jerabaul29/OpenMetBuoy-v2021a/development_environment/README.md

This contains information about how to set up your development environment to write / customize / develop firmware:

- **setup_arduino_v1-8_environment**: the arduino IDE v1.8 development environment, as used in the "legacy" instrument firmware.
- **setup_platformio_environment**: the PlatformIO development environment, as used in the "rewrite" instrument firmware.
