jerabaul29/OpenMetBuoy-v2021a/instrument_hardware/PCB.md

# Overview of the PCB(s) available

PCB makes assembly much easier and is the recommended way to assemble the OMB.

This is still a work in progress, if you want to get access to the current PCB, take contact directly through an issue or by email.
