jerabaul29/OpenMetBuoy-v2021a/latest_preprint_MDPI_2022.pdf

Citation: Rabault, J.; Nose, T., Hope, G.; Muller, M.; Breivik, Ø.; Voermans, J.; Hole, L.R.; Bohlinger, P.; Waseda, T.; Kodaira, T.; Katsuno, T.; Johnson, M.; Sutherland, G.; Johanson, M.; Christensen, K.H.; Garbo, A.; Jensen, A.; Gundersen, O.; Marchenko, A.; Babanin, A. OpenMetBuoy-v2021: an easy-to-build, affordable, customizable, open source instrument for oceanographic measurements of drift and waves in sea ice and the open ocean. Journal Not Specified 2022, 1, 0. https://doi.org/ (https://doi.org/10.3390/1010000)

Received:
Accepted:
Published:

Publisher’s Note: MDPI stays neutral with regard to jurisdictional claims in published maps and institutional affil-iations.

Copyright: © 2022 by the authors. Submitted to Journal Not Specified for possible open access publication under the terms and conditions of the Creative Commons Attri-bution (CC BY) license (https://creativecommons.org/licenses/by/4.0/).

Definitions/logo-mdpi-eps-converted-to.pdf (https://www.mdpi.com)

Article
OpenMetBuoy-v2021: an easy-to-build, affordable,

# customizable, open source instrument for oceanographic measurements of drift and waves in sea ice and the open ocean

Jean Rabault¹

, Takehiko Nose²

, Gaute Hope¹

, Malte Muller¹,3, Øyvind Breivik¹ , Joey
Voermans⁴

, Lars Robert Hole¹

, Patrik Bohlinger¹

, Takuji Waseda²,5, Tsubasa Kodaira² ,
Tomotaka Katsuno²

, Mark Johnson⁶

, Graig Sutherland⁷

, Malin Johanson⁸
, Kai Haakon
Christensen¹

, Adam Garbo⁹

, Atle Jensen³

, Olav Gundersen³

, Aleksey Marchenko¹⁰
,
Alexander Babanin⁴
1 | Norwegian Meteorological Institute
2 | The University of Tokyo
3 | University of Oslo
4 | The University of Melbourne
5 | Japan Agency for Marine-Earth Science and Technology
6 | The University of Alaska, Fairbanks
7 | Environment Climate Change Canada, Dorval
8 | UiT The Arctic University of Norway
9 | Carleton University, Ottawa, Ontario, Canada
10 | The University Center in Svalbard
* | Correspondence: jean.rblt@gmail.com

Abstract: There is a wide consensus within the polar science, meteorology, and oceanography communities that more in-situ observations of the ocean, atmosphere, and sea ice, are required to further improve operational forecasting model skills. Traditionally, the volume of such measurements has been limited by the high cost of commercially available instruments. An increasingly attractive solution to this cost issue is to use instruments produced in-house from open source hardware, firmware, and post processing building blocks. In the present work, we release the next iteration of the open source drifter and waves monitoring instrument of Rabault et. al. (see "An open source, versatile, affordable waves in ice instrument for scientific measurements in the Polar Regions", Cold Regions Science and Technology, 2020), which follows these solution aspects. The new design is both significantly less expensive (typically by a factor of 5 compared to our previous, already cost effective, instrument), much easier to build and assemble for people without specific microelectronics and programming competence, more easily extendable and customizable, and two orders of magnitude more power efficient (to the point where solar panels are no longer needed even for long term deployments). Improving performance and reducing noise levels and costs compared with our previous generation of instruments is possible in large part thanks to progress from the electronics component industry. As a result, we believe that this will allow scientists in geosciences to increase by an order of magnitude the amount of in-situ data they can collect under a constant instrumentation budget. In the following, we offer 1) detailed overview of our hardware and software solution, 2) in-situ validation and benchmarking of our instrument, 3) full open source release of both hardware and software blueprints. We hope that this work, and the associated open source release, may be a milestone that will allow our scientific fields to transition towards open source, community driven instrumentation. We believe that this could have a considerable impact on many fields, by making in-situ instrumentation at least an order of magnitude less expensive and more customizable than it has been for the last 50 years, marking the start of a new paradigm in oceanography and polar science, where instrumentation is an inexpensive commodity and in-situ data are easier and less expensive to collect.

Keywords: Waves in ice; Open Source; Instrumentation; In situ measurements; Oceanography; Waves; Sea surface drift; Open Ocean; Wave spectrum; Low cost.

Version February 14, 2022 submitted to Journal Not Specified | https://www.mdpi.com/journal/notspecified

Version February 14, 2022 submitted to Journal Not Specified | 2 of 26

### 1. Introduction

Our inability to accurately capture climatological changes of sea ice in the polar seas has created renewed interest in the dynamic interaction between sea ice and waves. This has resulted in the last few years into a number of studies that investigate the coupling between sea ice and the ocean through theoretical considerations [1–7], laboratory experiments [8–13], and field experiments [14–25]. Despite the advances that these studies bring, there is a growing consensus that further progress in the field can only be achieved through the collection of more observations of waves in ice. In particular, phenomena related to floe size distribution [4,26–28], energy dissipation due to turbulence and collisions [29–32], and sea ice breakup [33–36], are still unperfected modeled and understood, and advancing the state-of-the-art would require additional direct observations from the ice.
Unfortunately, one faces a number of challenges in reproducing the complexity of wave-ice interaction either in experiments (due to, for example, scaling issues [9], and the diversity and realism of sea ice conditions that can be obtained in the laboratory compared with the field [13]), or in models (there, also, due to the complexity and multi-scale proper- 43 ties of waves in ice and ice floe size distribution [37,38]). Arguably, the current state of the art in wave-ice interaction parametrization and modeling consists in a variety of (involved and mathematically advanced) models which formulations are relatively loosely based on some specific archetypical sea ice conditions and the associated physical mechanisms, with a number of "tuning parameters" that are empirically fitted to experimental or laboratory data [39,40]. This approach is quite ad-hoc and brittle, and this is in stark contrast with the importance of waves in ice and their impact on both weather and climate.
As a consequence, having access to large datasets of high temporal and spatial res- 51 olution direct observations of waves in ice, is a key ingredient to improving both small scale wave-ice interaction parametrization, large scale coupled wave-ice models, and our understanding of the weather and climate dynamics in the polar regions. There are a number of recent works that highlight the importance of the volume of such datasets for unveiling wave-ice interaction mechanisms. For example, Voermans et al. [15] showed that wave conditions that result in sea ice breakup events can be quite accurately described with a simple threshold mechanism, but that in order to be able to observe such a threshold, a relatively large aggregated dataset was necessary.
There are relatively few methods available for measuring waves in ice. The most common and established method considers the deployment of instrumentation in situ, providing surface truth of the sea ice motion under the influence of waves. Such instruments typically use either an Inertial Motion Unit (IMU, i.e. a combination of accelerometer, gyroscope, and magnetometer, together with some data fusion processing, e.g. Kohout et al. [41], Rabault et al. [42]), or a high accuracy GPS [43,44] to measure the sea ice motion and compute wave spectra. Less common techniques are the use pressure sensors to measure the wave-induced pressure fluctuation to derive wave observations [24]. Remote sensing is a promising avenue to obtain observations of waves in ice across large spatial scales [45,46] of far larger extent compared to what can be achieved with in situ instrumentation, though the number of wave parameters that can be retrieved, and the accuracy that can be achieved, is still limited and a topic for open research. Moreover, remote sensing requires considerable more in situ observations for calibration and validation. As a consequence, the most established and accurate method today is still to deploy instrumentation in situ to measure waves in ice.
Performing in situ measurements of waves in ice is, however, a challenging and costly operation. Commercial instruments have traditionally been extremely expensive, and sometimes of varying quality, with typical prices after taxes in the 7.5-50kUSD range. The situation got somehow better with the emergence of new actors, such as Sofar and their Spotter buoy [47], which took down the price to a typical 6-8kUSD cost per instrument, once

Version February 14, 2022 submitted to Journal Not Specified | 3 of 26

import taxes and satellite communication fees are factored in. Still, the Sofar Spotter, while gaining from being a very modern design, as well as relatively low cost, is not too well adapted for use in the polar regions, as it was designed primarily for measuring open water wave statistics, and, correspondingly, relatively large waves. In particular, its battery life limits the duration of deployments in the polar night [44]. In addition, its GPS-based wave measurement method, while having many advantages in open water (such as accurate directional wave spectrum measurement), has a lot higher noise for the typically small waves observed in the ice than what can be achieved with a modern Inertial Motion Unit (IMU).
As a consequence of these challenges, a number of groups have developed in-house, custom instrumentation for measurements of waves in ice [e.g., 41,42,48]. A very brief overview is provided in Fig. 1. This is, in our opinion, a situation that is so far quite inefficient. Indeed, a number of groups develop their own closed source solution, in parallel of each other, wasting a large amount of engineering resources in form of working hour and prototyping costs in the process.

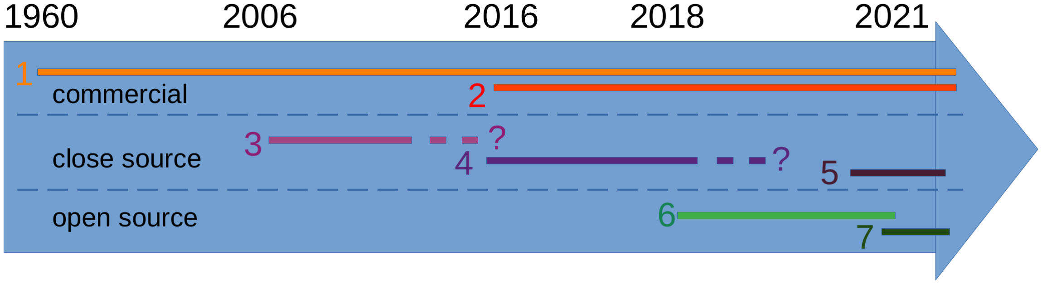
[picture p17: figure]

Figure 1. Overview of waves in ice instruments, distinguishing between i) commercial instruments, ii) close source instruments, iii) open source. Commercial instruments have been available for a long time, in particular the Datawell Waverider series of instruments (1), which goes back all the way to the 1960s [49]. More recently, the Sofar Spotter (2) has become a viable, lower-cost alternative, though there are a number of limitations in particular regarding battery autonomy [50], and the price. A number of groups have developed satellite-connected autonomous instruments that have been described in research articles, but that remained closed source. A few instruments we know about were released in 2006 (3) [48,51], 2016 (4) [41], 2021 (5) [25]. By contrast, our group has decided to release our designs as open source, so that can be freely used and improved by other groups, starting
in 2018 (6) [52] and now with the present design (7).
An increasingly promising direction is the development of open source instrumen- 95 tation, which allows to both reduce hardware costs and mutualize the instrumentation development workload. This approach was recently adopted by Rabault et al. [52] and has since its development in 2015 undergone several updates (the full lineage of our series
of open source instruments is presented in Fig. 2). In the following, we will refer to the design described in Rabault et al. [52] as the “v2018 instrument”, or “v2018” in short. Since 100 the initial deployment of the first v2018 instruments Rabault et al. [52], the low-cost and 101 open-source fundament of the instrument has promoted usage and international collabo- 102 ration across the world. The v2018, and adaptations thereof, have been deployed in both 103 the Arctic and Antarctic to study sea-ice drift [53], wave attenuation and dispersion [20], 104 and wave-induced sea ice break-up [15]. Through these collaborations and technological 105 advancements, points of improvement were identified, which supported to advance the 106 v2018 and develop the latest “v2021” version.
These challenges of high instrumentation costs and needs for more in-situ, ground 108 truth data, are not specific to the waves in ice community. Similarly, the rise of low cost (and 109 possibly open source) electronics is an evolution that is increasingly attracting the attention 110 of both research groups and public agencies across the world. For example, this trend can 111 be identified also in the technical development and history of the "Swift drifters" family, 112 among others, which are also advancing towards open source, low cost, "do it yourself" 113

Version February 14, 2022 submitted to Journal Not Specified | 4 of 26

technical solutions [54–56], focusing on measuring waves in the open ocean. Another 114 example of this trend is visible in recent works that focus on building small, inexpensive, 115 bio-degradable surface drifters [47]. Similarly, the Defense Advanced Research Projects 116 Agency (DARPA) is actively pursuing similar efforts with its "Ocean of Things" project 117 [57], which aims at "deploying thousands of low-cost, environmentally friendly, intelligent 118 floats that drift as a distributed sensor network" (quote from the Ocean of Things project 119
webpage, accessed Dec. 2021). | 120

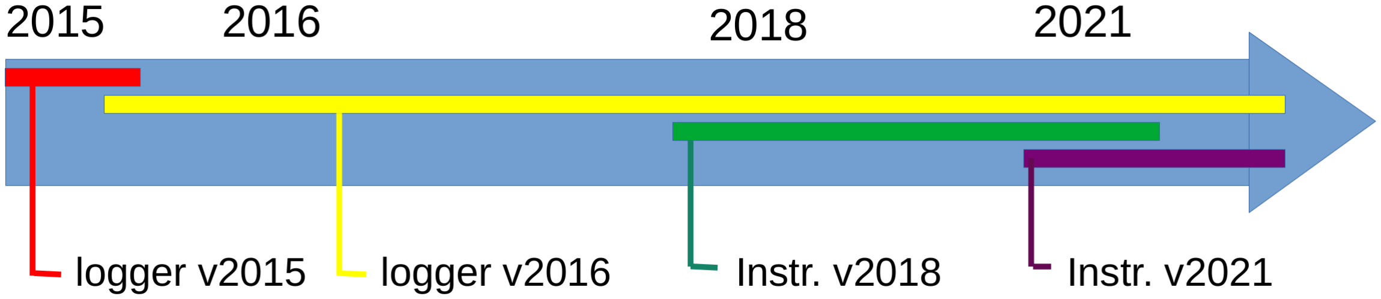
[picture p18: figure]

Figure 2. Full lineage of our present open source instrument. Developing reliable autonomous instruments is a long term effort. The development of our instrument can be tracked back to 2015
[42] and 2016 [22], though the instruments used at the time were simple loggers. Using loggers is still an attractive solution when the instruments can be recovered though, and the logger v2016 design is still in use today. By contrast our first truly autonomous, satellite-enabled instrument was designed
in 2017-2018 [52], and the present instrument is the second iteration around this design.

This paper is organized as follows. First, we discuss the general design and features 121 of the instrument v2021. Then, we present a detailed validation of the instrument v2021, 122 both i) in a preliminary deployment which aimed at validating the general concept of 123 the instrument and the power efficiency of the design, ii) in laboratory experiments that 124 tested the noise threshold of the waves measurements, iii) in a full-scale deployment in 125 the Russian Arctic, iv) in a full-scale deployment in the Caribbeans. Finally, we offer a few 126 words of conclusion and we present a roadmap for future development. All hardware 127 blueprints, embedded software, post processing codes, as well as detailed instructions, are 128
released as open source on Github, as indicated in the Appendix A. | 129
2. General design and features of the instrument v2021 | 130
2.1. Microcontroller | 131
Unlike the instrument v2018, and unlike all other wave measuring instruments that 132 we are aware of, the v2021 is based solely on a high performance microcontroller for 133 performing both data acquisition and in-situ data processing. This is a major shift from 134 previous designs, which usually resorted on some sort of embedded microcomputer for 135 performing the computation of wave spectra (typical previous solutions, such as those 136 based on a Raspberry Pi, run a stripped down version of Linux or Windows), with the 137 measurements themselves being performed either by the same microcomputer, or by a 138 separate, lower power microcontroller. This traditional approach has a dramatic effect on 139 power consumption. A typical microcomputer consumes around 1 to 2 W (for example, the 140 Raspberry Pi used in the v2018 consumes typically up to around 350mA while running 141 at a 5V voltage), while a modern microcontroller can consume as little as 1 to 2 mW 142 (the microcontroller used in the v2021 consumes typically 500 µA while running at a 143 3.3V voltage). This factor 1000 in power efficiency allows for significant simplifications 144 and flexibility in the instrument design. This is of particular importance to instrument 145 performance in the polar regions where the battery is generally the main limiting factor 146 in the field experiment duration. In addition, microcomputers will rely on a complete 147 operating system for running their workloads. These are complex pieces of software, with 148 several possibilities for things to go wrong, and require the user to implement a number of 149 techniques to avoid locking of the system. By contrast, microcontrollers can be programmed 150

Version February 14, 2022 submitted to Journal Not Specified | 5 of 26

without the use of any operating system, which allows to build more robust embedded 151
systems that are more reliable in demanding remote environments. | 152
To this end, the instrument v2021 uses an Ambiq Apollo 3 BLU ultra low power 153 microcontroller unit [58], embedded within a board from the Sparkfun Artemis ecosystem 154 [Artemis Global Tracker, 59]). This allows to use the complete Sparkfun Artemis ecosystem 155 toolchain to simplify the programming of the Ambiq Apollo using high level C++ code. 156 Effectively the user is able to use off-the-shelf, modular, high level libraries and does 157 not need to perform low level drivers and firmware development. The Ambiq Apollo 158 microcontroller used is an ARM Cortex M4-F implementation that runs at 48MHz (with 159 a 96MHz boost mode), uses 500 µA of sustained power at 3.3V, and features a complete 160 floating point unit for performing fast mathematical operations. Since this processor is 161 an ARM Cortex M4 implementation, the full ARM-developed libraries for digital signal 162 processing, including a wide range of spectral analysis tools, are available out of the box 163 through the Sparkfun toolchain which includes a copy of the CMSIS library (this features, 164 in particular, real and complex FFTs, cross correlation computations, and similar, which 165 are available as highly optimized, ready-to-use functions). The total non volatile memory 166 available for storing the program is amounting to 1MB, and the RAM has a size of 384kB. 167 To put this in perspective, storing 20 minutes of IMU data recorded at 10Hz into RAM, 168 processing the data, and sending the processed data through Iridium, occupies around 169 one third of the total memory available on the chip. This means that a lot of additional 170
customized functionality can be added in the future to the v2021. | 171
2.2. Wave data acquisition and on-board processing | 172
The wave data acquisition is performed by a 9 degrees of freedom (9-dof) sensor, which 173 performs high-frequency measurements of acceleration, angular rates, and magnetic field 174 on the X, Y, and Z axis of the sensor chip. An industrial quality, thermally compensated, low 175 noise sensor is used for this (the ST ISM330DHCX together with the LIS3MDL). At present, 176 only the vertical wave spectrum is computed, and the absolute orientation (provided by the 177 magnetometer) is not used but can be used in the future to derive directional information. 178 The raw accelerometer and gyroscope data are sampled at approximately 800Hz, and 179 time averaged into a 100Hz low-noise sensor value. When performing this averaging, a 180 3-sigma filtering stage is used, i.e., individual measurements that deviate from the rest of 181 the current 800Hz sample by more than 3 standard deviations are rejected. This means 182 that each set of 8 samples at 800Hz, spanning over 10 milliseconds, is filtered (with the 183 n-sigma filter) and averaged. This allows to discard occasional bad quality measurements 184 (in our experience, a few such measurements are obtained in a 20 minutes measurement 185 segment; this is most likely inherent to the kind of sensor used, and / or may come from 186 rare irregularity in the functioning of either the 9dof sensor or the firmware used for 187 communicating with it), to avoid any risk of signal aliasing, and to reduce the noise level 188 by performing averaging. This low-noise sensor value averaged at 100Hz is then fed 189 in real time to a Kalman filter run on the Ambiq Apollo microcontroller at 100Hz. The 190 Kalman filter itself is provided by an Attitude and Heading Reference System (AHRS) C++ 191 embedded open source library, provided to the community by Freescale Semiconductors. 192 The Kalman filter implementation performs data fusion for 9-axis MEMS input (i.e. 3-axis 193 accelerometer, gyroscope, and magnetometer), and produces an accurate estimate for the 194 absolute orientation of the sensor in a North, East, Down frame of reference. The Kalman 195 filter output is used for computing the vertical component of the wave acceleration at 196 100Hz by projecting the acceleration from the X, Y, Z frame of reference onto the vertical 197 direction, following the absolute orientation information provided by the Kalman filter as a 198 quaternion, and subtracting the constant gravity acceleration. Finally, the processed 100Hz 199 vertical acceleration measurement is time averaged to 10Hz. This output frequency is 200 sufficient to measure either wind waves (typical peak frequency 0.2Hz), swell (typical peak 201 frequency from 0.08 to 0.10Hz), and waves in ice (typical peak frequencies corresponding 202 to swell, or slightly lower, due to the increased damping rate at higher frequencies), 203

Version February 14, 2022 submitted to Journal Not Specified | 6 of 26

and is a value commonly used in other waves in ice instruments [52]. If necessary, this 204 output sampling frequency can be increased by the user, and the resources available on 205 the microcontroller could allow for at least 20Hz sampling rate. The whole procedure is 206 implemented through a couple of classes in the code and performed instantaneously. The 207 reader is referred to the open source implementation released on Github (see Appendix A) 208
for more details. | 209
Resorting to a simple 9-dof sensor and running the Kalman filter on the Artemis 210 microcontroller is both much more power effective (total power consumption is around 211 5mA for the proposed solution, compared with typically 35mA using a dedicated full- 212 feature IMU) and significantly less expensive than using a single discrete Inertial Motion 213 Unit component which performs both tasks on its own (the cost of a high quality 9dof sensor 214 is around 15USD, compared with 50 to 1000USD for a lower accuracy, or similar accuracy, 215 IMU, respectively). Pseudocode for the data acquisition and Kalman filter processing is 216
presented in the description of Algorithm 1. | 217

initialize empty BufferVerticalAcceleration10Hz;
initialize KalmanFilter100Hz;
while need more vertical acceleration measurements at 10Hz do
initialize empty BufferVerticalAcceleration100Hz
for CurrentVerticalAcceleration100Hz in [0..10[ do
initialize empty BufferAcc[X,Y,Z]800Hz, BufferGyr[X,Y,Z]800Hz, BufferMag[X,Y,Z]800Hz;
for Current9dofMeasurement800Hz in [0..8[ do
measure Acc[X,Y,Z] and append to BufferAcc[X,Y,Z]800Hz; measure Gyr[X,Y,Z] and append to BufferGyr[X,Y,Z]800Hz; measure Mag[X,Y,Z] and append to BufferMag[X,Y,Z]800Hz;
end
3-sigma-average BufferAcc[X,Y,Z]800Hz into Acc[X,Y,Z]Average100Hz; 3-sigma-average BufferGyr[X,Y,Z]800Hz into Gyr[X,Y,Z]Average100Hz; 3-sigma-average BufferMag[X,Y,Z]800Hz into Mag[X,Y,Z]Average100Hz; update KalmanFilter100Hz using Acc[X,Y,Z]Average100Hz, Gyr[X,Y,Z]Average100Hz, Mag[X,Y,Z]Average100Hz;
obtain QuaternionAbsoluteOrientation100Hz from KalmanFilter100Hz; compute CurrentVerticalAcceleration100Hz from QuaternionAbsoluteOrientation100Hz, Acc[X,Y,Z]Average100Hz; push CurrentVerticalAcceleration100Hz to BufferVerticalAcceleration100Hz
end
average BufferVerticalAcceleration100Hz into CurrentVerticalAcceleration10Hz;
push CurrentVerticalAcceleration10Hz to BufferVerticalAcceleration10Hz;
end
return BufferVerticalAcceleration10Hz;
Algorithm 1: Sampling of vertical acceleration at a frequency of 10Hz in a dedicated buffer, including raw data sampling and pre-averaging, Kalman filtering, and vertical acceleration post-averaging. "Acc" stands for "Acceleration", "Gyr" stands for "Gyroscope", "Mag" stands for "Magnetometer". 3-sigma-average is an averaging filter rejecting measurements deviating from the rest of the sample by more than 3 standard deviations, which is used to discard occasional bad readings. The combination of high-frequency averaging of the raw input from 800Hz to 100Hz, Kalman filtering and vertical acceleration computation at 100Hz, and vertical acceleration averaging from 100Hz to 10Hz, allows to balance the need for computational efficiency (by reducing the number of expensive Kalman filter updates) and accuracy (by running the raw data collection at high-frequency and using all the data available through time averaging).

The wave elevation data processing is also performed on the Ambiq Apollo micro- 218 controller. At the end of a 20 minutes measurement period (or, to be more exact, 20.48 219

Version February 14, 2022 submitted to Journal Not Specified | 7 of 26

minutes, to obtain a multiple of 2048 = 2

11 samples to allow much faster FFT computation), 220 the array of 10 Hz vertical acceleration data stored in RAM is processed using the Welch 221 method. For this, the signal is split into segments of length 2048 sample points, with a 222 75% overlap, resulting in a total of 21 segments. This corresponds to segments with length 223 double of what was used in Rabault et al. [52]. The motivation for doubling the segment 224 length is to increase the frequency resolution of the output. In addition, we use 75% overlap, 225 instead of 50% overlap used in Rabault et al. [52], in order to keep the number of segments 226 large enough to perform a good averaging despite the increase in segment length. The 227 real FFT for the vertical acceleration of each of these segments is computed using the real 228 FFT implementation provided by the ARM digital processing reference library, applying 229 Hanning windowing with an energy-conserving normalization, and these segment FFTs 230 are averaged into the Welch estimate. The computation of the FFT takes just a few tens of 231 milliseconds due to the dedicated floating point unit on the Ambiq Apollo microcontroller, 232 and the efficient FFT algorithm provided by ARM. The corresponding algorithm is sum- 233 marized in Algorithm 2. The reader who may want to re-implement a similar algorithm is 234 made aware that different FFT libraries may use different renormalization conventions, so 235 that using another FFT implementation may require the use of additional scaling factors. 236 In order to save memory, the Welch averaging is only performed for the set of frequency 237 bins corresponding to frequencies that are relevant for waves, which is typically between 238
fmin = 0.05Hz (i.e. 20s period waves) and fmax = 0.5Hz (ie 2s period waves). | 239
The Welch spectrum with Hanning windowing obtained at this stage is a low-noise 240 estimate for the spectrum of the wave vertical acceleration, PSDaccD. From there, the 241
spectrum of the wave elevation η can be obtained following [21]: | 242

PSDη(f) = PSDaccD(f)/(2.0π f)

4
. | (1)
Finally, the spectral moments are computed following: | 243

mi =

Z fmax

fmin

PSDη(f)f

i
d f , | (2)

and these are used to compute estimates of the significant wave height Hs and the wave 244
period Tz and Tc, following: | 245

Hs = 4

√
m0, | (3)

Tz =

p
m2/m0, | (4)

Tc =

p
m4/m2. | (5)

Since the full wave spectrum is transmitted (see the next section), these statistics are 246 simply redundant information (as they can be derived from the transmitted spectrum) 247 that are convenient to use for consistency checks, or for quickly inspecting wave data as 248 they are transmitted. We choose to transmit these quantities to remain consistent with the 249 previous design of Rabault et al. [52], as these are well adapted to our needs, but users 250 are free to implement the transmission of other statistics (such as the zero crossing period 251 T01 = m0/m1, or the harmonic period T−10 = m−1/m0) if this is a better fit for their needs, 252
owing to the open source nature of the instrument. | 253
We want to remind those readers who may want to re-implement this processing again 254 that different FFT packets may use different conventions, so that additional renormalization 255 factors may be needed. Similarly, some references in the literature use the angular frequency 256 ω = 2π f rather than the frequency f as a dimension for spectra, in which case some 257 additional renormalization is needed in the formula above. Our general recommendation 258 is to test the whole processing algorithm on dummy synthetic data to ensure that no 259 renormalization factor has been forgotten. Moreover, we used additional checks during 260

Version February 14, 2022 submitted to Journal Not Specified | 8 of 26

input: BufferVerticalAcceleration10Hz, length 6 * 2048 samples;
initialize array HanningWelchSpectrum[RelevantIndexRange] with all elements = 0;
// the RelevantIndexRange includes the reduced span of the 2048-point FFT
// that covers frequencies between 0.05Hz and 0.5Hz, ie from fmin to fmax initialize CurrentSignalSegmentStart = 0;
initialize CurrentSignalSegmentEnd = 2048;
for CurrentWelchSegment in [0..21[ do
copy BufferVerticalAcceleration10Hz[CurrentSignalSegmentStart..CurrentSignalSegmentEnd[ into CurrentFFTInput[0..2048[;
// apply Hanning windowing
for CurrentIndex in [0..2048[ do
CurrentFFTInput[CurrentIndex] *= 1.63 * [sin(π * CurrentIndex / 2048)]² end
compute realFFT of into HanningCurrentFFTOutput; HanningWelchSpectrum[RelevantIndexRange] += 2.0 * | HanningCurrentFFTOutput[RelevantIndexRange]²
| ;
// the realFFT of a real input signal is a vector of complex numbers; we need to extract the
// complex magnitude squared of each bin; in our case, a renormalization of 2.0 is needed since
// the output is only the half spectrum, i.e. the negative frequencies part of the spectrum
// which is equal to the conjugate of the corresponding positive frequency part is omitted
CurrentSignalSegmentStart += 2048 / 4;
CurrentSignalSegmentEnd += 2048 / 4;
end
HanningWelchSpectrum[..] = HanningWelchSpectrum[..] / 21;
return HanningWelchSpectrum;
Algorithm 2: Algorithm used for computing the Welch spectrum with energy-conserving Hanning windowing. We have decided to use 21 segments with 75% overlap when computing the Welch averaging. Note that the exact value of the renormalization coefficients needed may depend on the specific FFT implementation used and the normalization convention that it defaults to.

Version February 14, 2022 submitted to Journal Not Specified | 9 of 26

the development of the code to make sure that the scaling and processing as a whole is 261 correct, such as verifying that the Parseval theorem holds by checking that the variance of 262 the heave displacement is equal to the integral (with respect to frequency) of the power 263
spectral density. | 264
2.3. Satellite communications | 265
After the recorded data is processed, the data (composed of the Welch wave acceler- 266 ation spectrum between fmin and fmax, the estimates for Hs, Tz, and Tc, as well as UTC 267 timestamp information) are packed into a binary packet. In order to reduce the size of 268 the binary packet, the estimates for Hs, Tz, and Tc are transmitted as 32-bit floats, while 269 the Welch frequency bins are discretized into renormalized 16-bit unsigned integers. The 270 renormalization of the Welch bins is performed relatively to the peak value of the spectrum, 271 which is transmitted as a 32-bit float within the packet. This allows to significantly reduce 272 the size of the binary packets and the overall iridium costs while keeping a high accuracy 273
for the data transmitted. | 274
In addition to the wave spectrum, geographical positioning is obtained with a simple 275 GNSS module, and is also used to generate accurate UTC reference times and to periodically 276 re-calibrate the real time clock of the microcontroller to avoid time drift. The GNSS data 277 are packed, buffered, and transmitted using an efficient binary encoding, similar to what is 278
done for the wave data. | 279
The sample rate of both the GNSS and the wave measurements can be adapted through 280 2-way iridium communication. In addition, the real time clock present on board on the 281 microcontroller is used to make sure that the measurements are performed at fixed hours 282 and minutes. In order to reduce iridium costs and energy consumption, the firmware can 283 pack several binary packets packages together before transmitting these as a single iridium 284 message. As all iridium communications are buffered on the microcontroller, any data 285 not transmitted due to failure in iridium communication can be retransmitted at the next 286 transmission attempt to prevent data loss. When an Iridium communication is established, 287 the instrument transmits a burst of several messages, sending back to the user all the 288
information that are stored in the binary message buffers. | 289
A simple binary protocol decoder, available as a Python module, is provided alongside 290 the code for the instrument firmware. This, together with the web interface or web API 291 offered by modern Iridium providers (in our case, we use Rock Seven Mobile Services Ltd, 292 though other providers would be possible), allows great flexibility and ease-of-use for the 293 end user. Those tasks can easily be automated, and we provide a custom bash script for 294 performing https requests directly to the server of RockSeven, which allows to retrieve all 295
the iridium messages received over a user-selected time span, as a csv database. | 296
2.4. Ongoing instrument variant: cellular communication | 297
A derivate of the satellite based buoy is being developed to communicate through 298 the cellular network instead. Using the same data-processing and setup means that the 299 buoy takes advantage of the previous validation. The purpose of a buoy operating on the 300 cellular network is 1) lower cost (by a factor of 2 to 3 for the hardware, and up to 50 for 301 the communication), 2) higher data-rates: time-series of continuous measurements can be 302
transmitted if necessary. | 303
The buoy will operate under the limitation that it cannot stray far from the coast, and 304 the target areas reflect this: near-shore breaking wave measurements and drift and wave 305 measurements inside fjords in Norway. The buoy will be designed to store as much data 306 as possible locally if network service is temporarily unavailable. If the buoy runs out of 307 memory in the mean time it will drop uncritical data, and store only processed data. In 308 addition to the internal memory about 900kB of additional memory is available through 309 the cellular modem for caching data, and other memory devices may be added at small 310
extra cost and power usage if necessary. | 311

Version February 14, 2022 submitted to Journal Not Specified | 10 of 26
2.5. Battery autonomy and power-saving strategies | 312
Reliable power supply is a critical concern for waves in ice instruments due to the cold 313 temperature conditions and the inability for solar power usage during polar night. In the 314 present design, we decided to avoid the use of solar panels altogether (though solar panels 315 could be easily added for building an open ocean buoy with unlimited autonomy outside 316 of the polar regions). This allows to simplify the design, makes it less expensive and less 317 labor intensive to produce, as well as avoids compromising the water-tightening of the 318 instrument. In our case, the combination of a power-efficient microcontroller and 9dof, as 319 well as power-optimized firmware, led to a drastic reduction of the power consumption 320 compared with previous generations of the instrument. Table 1 summarizes the power 321 consumption of the instrument in different modes. We use as power sources Lithium 322 D-cells (SAFT LSH20), that have a nominal capacity of around 13Ah at 3.6V. In addition, a 323 3.3V step up-step down buck converter [60] is used to provide a stable 3.3V power source, 324 even when the iridium modem briefly needs to draw much more power (bursts up to 325 250mA). This results in a typical operational time, with 2 Lithium D-cells mounted in 326 parallel and no solar power, of around 4.5 months with our standard GNSS and waves 327 measurement rates (GNSS position every 30 minutes and wave spectrum every 2 hours). 328 If needed, increasing the number of batteries used in parallel will allow to increase the 329 autonomy, proportionally to the number of cells used. In order to simplify the handling and 330 deployment of the instrument, a magnetic switch was added to the design [61]. When the 331 magnet is attached, the instrument is powered down. The instrument starts operating as 332 soon as the magnet is removed, and can be switched on and off as many often as necessary. 333 Some LEDs are used to provide visual indication of instrument activity, while their blinking 334
frequency is taken low enough to preserve battery. | 335
activity mode | activation frequency | current (mA) | mWh use per hour | time to empty 2 Li D-cells
sleep | when not active | 0.3 | 1.0 | 7.3 years
gnss measurement | 2 minutes twice per hour | 30 | 3.3 | 2.2 years
wave measurement | 20 minutes every 2 hours | 8 | 4.4 | 1.6 years
iridium transmission | 1 message per hour | burst 250mA | 10 | 0.7 years
typical use | | | 18.7 | 0.39 years ≈ 4.6 months

Table 1. Overview of the power consumption and resulting battery autonomy resulting from the different components of the instrument when using two non rechargeable D-sized Lithium batteries. ’Activity mode’ indicates which part of the workflow of the instrument that is being considered. ’Activation frequency’ indicates a typical activation duration and frequency (though this is only indicative, and may be modified either by using different parameters when programming the instrument, and / or by sending updated activity rates through the bi-directional iridium communication). ’Current (mA)’ is the average current used in the corresponding mode when it is active. ’mWh use per hour’ indicates the corresponding energy use for the given activation mode, following the formula: mWhUsePerHour = Current(mA) × 3.3(V) × ActivationFraction.

The high level logics of the instrument (wake-up patterns, measurements patterns, 336 iridium burst mode transmission) is implemented as a few lines of code that leverage 337 an object oriented implementation of the processing components described above. To 338 increase robustness of the firmware after instrument malfunction, we resort to a double 339 strategy. First, the firmware is coded following defensive programming patterns, with 340 extensive quality checks of all inputs and outputs for the different modules used. Second, 341 the integrated hardware watchdog present on the microcontroller is enabled at all time, in 342 order to force a complete reboot of the microcontroller in case of a hardware or a software 343 malfunction. The test deployments have all been highly successful as described in Section 344
3, which is a testimony to the robustness of the design. | 345

Version February 14, 2022 submitted to Journal Not Specified | 11 of 26
2.6. Total cost and assembly process | 346
The total bill of materials is presented in Table 2. We consider that around 0.5 hours of 347 work is needed to assemble one single instrument. No advanced electronics or hardware 348 experience is required to build the instrument. At present, the assembly relies on a couple 349 of soldering steps to connect the power supply module to the main board, and simply 350 plugging the 9dof sensor and the electronic switch controlling it into the main board using 351
a couple of Qwiic I2C cables. | 352
component | function | price (USD) | assembly steps
Artemis Global Tracker | main board, MCU, GNSS, Iridium | 375 | ready to use
GNSS + Iridium antenna | passive antenna | 65 | screw on SMA cable
SMA extension cable 25 cm | extension cable for antenna | 5 | screw on tracker
Qwiic power switch | power on and off 9dof | 7 | disable LED, connect 9dof and tracker
ISM330DHCX + LIS3MDL | 9dof sensor | 18 | connect to power switch
Qwiic cables (x2) | connect tracker, 9dof, switch | 3 | connect power switch and 9dof
3.3V Regulator S7V8F3 | 3.3V buck converter | 10 | solder to battery and tracker
2 x D cell holders | house and connect batteries | 15 | solder to 3.3V regulator
2 x SAFT LSH20 | power supply | 35 | put in cell holders
reed MDRR-DT-20-35-F | magnetic switch | 3 | solder between battery and regulator
magnet | turn magnetic switch on / off | 1 | mount outside housing
housing box | housing, IP68 | 20 | mount the electronics inside
misc: glue, wire | small extras | 5 | get the design assembled
total | fully functional instrument | 562 | 0.5 hours / instruments, producing 10
Table 2. A representative list of components needed to build an instrument monitoring drift (GNSS) and wave activity (9dof sensor). The assembly time for a single instrument, when assembling a series of 10 instruments in bulk, is about 0.5 hours once the user is familiar with the design.
functionality | credits / message | messages / hour (default) | price / month (USD)
iridium subscription fee 1 month | N/A | N/A | 16
GNSS position data | 2 | 0.3 | 26
wave spectrum data | 3 | 0.5 | 66
total | N/A | N/A | 108
Table 3. Overview of the Iridium communication costs. The prices correspond to the ones offered by RockSeven at the time of writing this manuscript. It is possible to modify the rate of data collection by either using different setups when one programs the instrument firmware, or by sending a measurement rate update command to the instrument through iridium.

The total weight of the instrument depends on the size of the enclosure and the number 353 of battery cells used. Typical weight is between 0.3 and 0.5kg with 2 lithium D-cell batteries. 354 The dimensions of the instrument are typically around 12cm x 12cm x 9cm. Many of these 355 parameters are part of design tradeoffs. For example, more batteries increase weight and 356 would make deployment from drones more challenging, but also allow to extend battery 357 time. The use of a small enclosure allows for easier shipping and logistics and make the 358 instrument less likely to be discovered (and destroyed) by polar bears (in the Arctic), but 359 means that even a relatively minor snowfall is enough to bury the instrument and interrupt 360
GNSS and Iridium signals. | 361
In addition to the construction costs, Iridium costs can be significant over time. Table 362 3 indicates the typical Iridium communication costs per month, for an instrument running 363 with the default parameters (reducing the frequency of measurements will reduce costs 364
accordingly). | 365

Version February 14, 2022 submitted to Journal Not Specified | 12 of 26

Combining the building and the Iridium costs, the total cost per instrument, for an 366 activity period of 6 months (which is reasonable for instruments deployed in the MIZ at the 367 start of the ice formation season), is around 1200 USD, all included (noting that 4, rather 368 than 2, LSH20 batteries will be necessary for such a deployment). Around 53% of this cost 369 comes from the Iridium transmission fees, so reducing the frequency of measurements 370 when little activity of interest is happening will allow to significantly reduce the total cost 371
of ownership. | 372
3. Validation of the instrument v2021 | 373
3.1. Autonomy and satellite communication test in the Arctic: February 2021 deployment | 374
An early version of the instrument v2021, which performed drift tracking but no waves 375 measurements, was deployed East of Svalbard in February 2021 [62]. This early version 376 of the instrument was used to i) validate the general design of the electronics, ii) validate 377 the low power modes and the ability of the instrument to live for several months in the 378 Arctic cold using just a couple of D-sized battery cells, in particular, regarding the power 379 consumption of the iridium modem which is hard to estimate, iii) validate the satellite 380
communication binary protocols. | 381
This initial test was a success. The instrument was deployed on February 24th, 2021, 382 East of Svalbard. It then transmitted data for a few weeks, before a snow storm covered 383 it with snow and blocked the iridium transmission. This loss of communications is a 384 consequence of the design of the housing of the instrument, that relied on a box that was 385 too low to survive even just 10 cm of snow, and will be addressed in future designs, by 386 using a box that is higher and does not get buried as easily. However, communication with 387 the Iridium satellites was restored when the ice melted in late May 2021. Following this, 388 the instrument freely floated in the open sea, traveling all the way from Svalbard to the 389 close vicinity of Murmansk, and back and forth between Novaya Zemlya and Murmansk. 390 An overview of the trajectory is presented in Fig. 3. At the time of writing this 391 manuscript, i.e. January 2022, this instrument is still transmitting. The instrument was 392 powered by 3 LSH20 batteries, which, since it measures only GNSS position each 30 393 minutes, should result in a battery life of around a bit over 1 year following the data from 394 Table 1. Therefore, this deployment validates the low power design, and confirms that both 395 the low power sleep mode, the GNSS data acquisition, and the Iridium transmission (which 396 have the power consumption that is most difficult to estimate), are correctly implemented 397
and allow extended operation on battery alone. | 398
3.2. Experiments for validation of small-amplitude, low frequency harmonic vertical displacement | 399
measurements at the University of Tokyo’s wave-ice tank facility: July 2021 laboratory test | 400
We conducted an experiment in July 2021 to evaluate the instrument v2021 accuracy 401 for measuring small amplitude harmonic vertical displacement representative of waves 402 in ice. This experiment allows to fully validate i) the acquisition of raw data from the 403 9dof sensor, ii) the processing algorithm and scaling factors used in the low-level signal 404 processing code, iii) the data encoding used for transmitting the information back to the 405 user. The experiment took place in the wave-ice tank facility at the Kashiwa campus of 406 the University of Tokyo, Japan. In our case, however, the instrument v2021 prototype 407 was placed on the top of the wavemaker paddle (which is a plundging wedge, vertical 408 displacement paddle), rather than in the water (see Fig. 4), so it measured the vertical 409 motion of the wavemaker itself, which is known to a very high accuracy thanks to the 410 use of a close-loop control. Indeed, even given the presence of a damping beach, it would 411 be challenging in such a small wavetank to avoid reflections and standing waves, and to 412 provide waves of sufficient amplitude at such low frequencies. By contrast, by placing the 413 instrument on top of the paddle which is controlled by a close loop constrol system, we 414 ensure that the vertical displacement of the instrument is exactly equal to the one specified 415 in the control system. In this section, we will refer to the displacement prescribed as 416 "wavemaker signal", to emphasize that the signal we measure is the vertical displacement 417

Version February 14, 2022 submitted to Journal Not Specified | 13 of 26

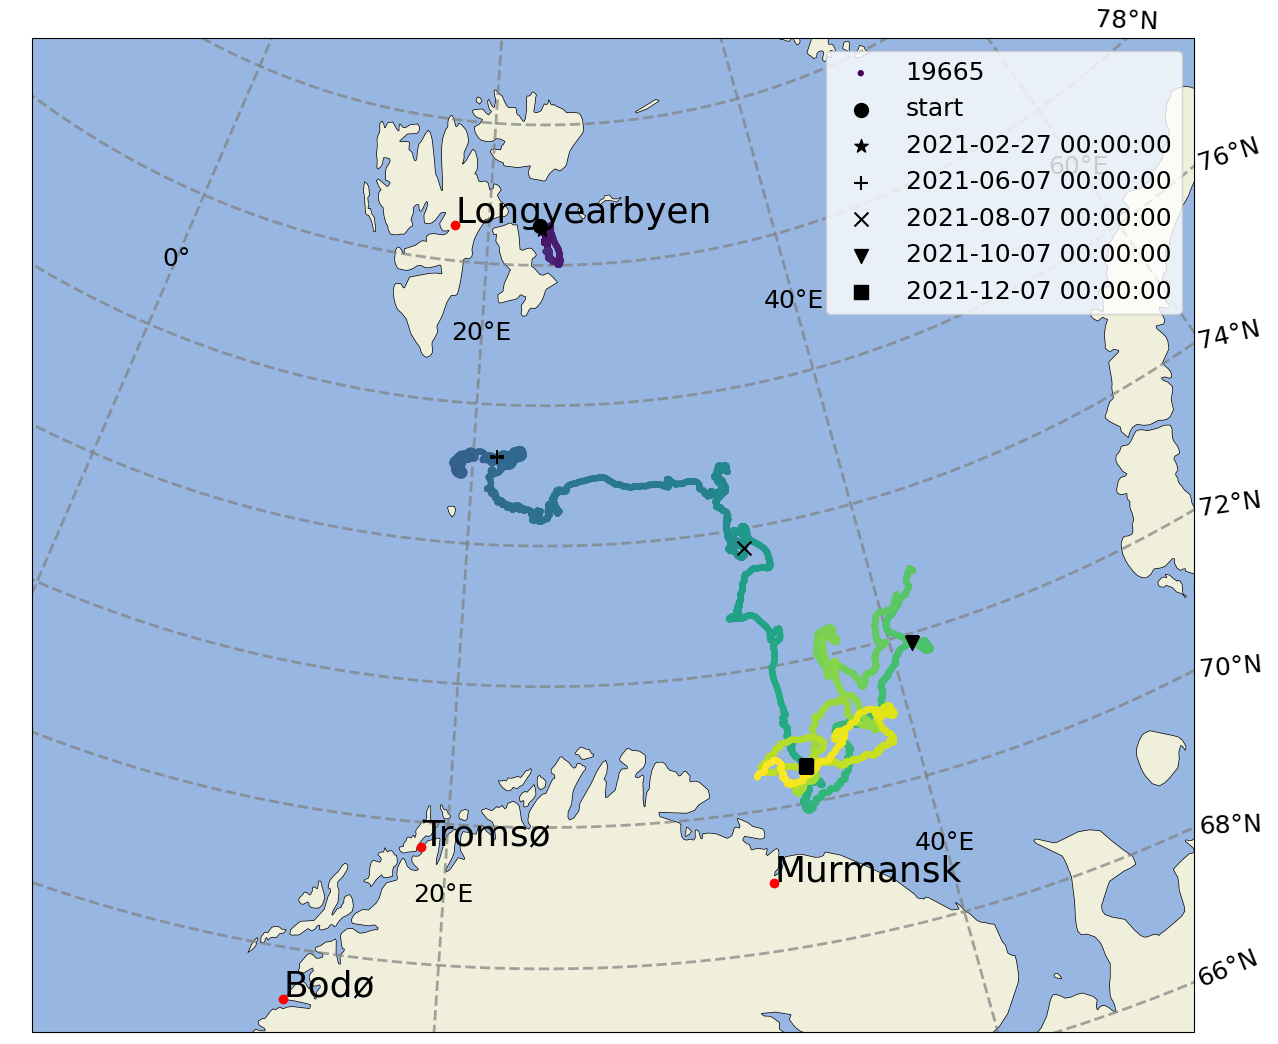
[picture p19: figure]

Figure 3. Overview of the drift trajectory of the early prototype instrument deployed in February 2021 East of Svalbard. The interruption in the trajectory is due to a layer of snow covering the instrument that prevented satellite communications during a couple of months. The instrument then drifted freely in the open ocean. This validates the low power design, and confirms that the design chosen is able to sustain operations for several months using just a few D-cell Lithium batteries.

of the plunger-type wavemaker on which the instrument sits, rather than the motion of the 418
water. | 419
The experiment aims to evaluate the instrument accuracy when it measures centimeter 420 scale vertical displacement signals at low frequencies corresponding to typical waves in ice 421 conditions. As such, we tested the instrument using both 1 and 2 cm amplitude sinusoidal 422 wavemaker vertical motion for 12, 14, and 16 s periods (as well as an "extreme" test with 0.5 423 cm amplitude and 16 s period, to test the very limit of the instrument sensitivity), which 424 resemble lower-bound wave signals that were previously measured in ice-covered ocean 425 [15]. The spectral analysis setup was slightly modified from that of Section 2.2, so that 426 each test case duration was reduced from 20 mins to roughly 7 mins, in order to be able to 427 perform the tests within the allocated time slot. For this, the segment overlap was reduced 428 to 50% (corresponding to 1024 points), which yields a total number of 3 segments per 429 7 mins measurement interval. All other processing configuration remained the same as 430
Section 2.2. | 431
The wavemaker signal experiment results are summarized in Table 4. The frequency 432 of the wavemaker motion was not tuned to the exact frequencies bins, nevertheless, the 433 peak of the energy was consistently captured in the nearest frequency bin, as reflected in 434
Table 4. Then, the best estimate of the wave amplitude can be derived as: | 435

Amono =

q
d f × (S(i − 1)

2 + S(i)

2 + S(i + 1)

2), | (6)

where S(i) is the spectrum produced by the instrument, taken at the peak of the amplitude 436 spectrum, and we consider also the neighboring frequency bins. The results of the wave- 437 maker signal experiments summarized in Table 4 indicate that the instrument is capable of 438 measuring monochromatic wave amplitudes of 1 to 2 cm with roughly 0.1 cm accuracy. 439 The spectra obtained during these tests, as well as two spectra corresponding to the 440 instruments being at rest, are presented in Fig. 5. As visible there, the noise background 441 of the instrument increases slightly when motion is present, which may be explained by a 442 variety of reasons (small vibrations in the wave paddle mechanism when it is undergoing 443 displacement, diffusion of numerical noise in the processing algorithms, inherent properties 444

Version February 14, 2022 submitted to Journal Not Specified | 14 of 26

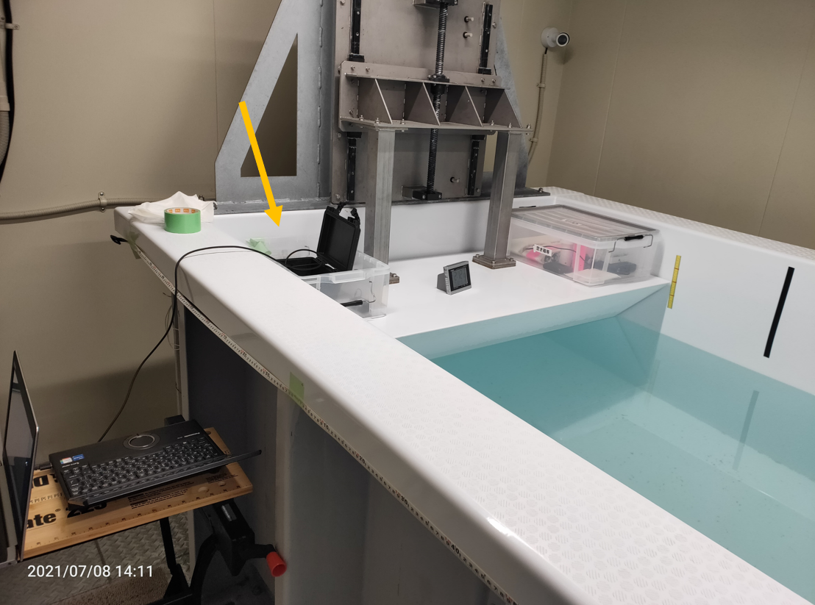
[picture p20: figure]

Figure 4. Illustration of the wavemaker experiment setup in the wave-ice tank of JAMSTEC (Japan Agency for Marine-Earth Science and Technology) at the Kashiwa campus of the University of Tokyo, Japan. The instrument v2021 location is shown by the yellow arrow.

Wavemaker signal: amplitude, period | Reported buoy amplitude (cm, averaged) | Reported buoy peak period (s) | frequency bin closest to peak frequency | Number of cases
2 cm, 16 s | 2.104 | 15.75 | yes | 4
1 cm, 16 s | 1.040 | 15.75 | yes | 2
0.5 cm, 16 s | 0.62 | 15.75 | yes | 2
2 cm, 14 s | 1.954 | 13.65 | yes | 1
1 cm, 14 s | 1.053 | 13.65 | yes | 1
2 cm, 12 s | 2.022 | 12.05 | yes | 2
1 cm, 12 s | 0.970 | 12.05 | yes | 2

Table 4. A summary of wavemaker signal experiment results. The experiments included 1 and 2 cm amplitude waves for 12, 14, and 16 s periods, as well as an "extreme" test corresponding to an amplitude of 0.5cm at 16s period. When multiple tests were conducted, the mean values are reported. The instrument is able to accurately measure waves down to 1 cm at a 16s period, with a corresponding typically accuracy of under 0.1 cm. For waves of amplitude 0.5cm and period 16s, the peak period is still correctly identified, but noise in the measurements starts to play a role, with a deviation of around 25% in the wave amplitude value reported.

Version February 14, 2022 submitted to Journal Not Specified | 15 of 26

of the 9dof sensor). However, the increase in the noise threshold when there is motion 445 remains very limited. The signal-to-noise ratio is superior or equal to a factor of 50 in 446 all experiments, except for the smaller waves (0.5cm at 16s period), in which case the 447 signal-to-noise ratio is around 10. This means that, even in this last "extreme" test case, 448 the signal-to-noise ratio is still good enough to clearly distinguish the motion from the 449 noise floor, though noise starts to be visible in the integrated statistics, as discussed in the 450
previous paragraph and in Table 4. | 451

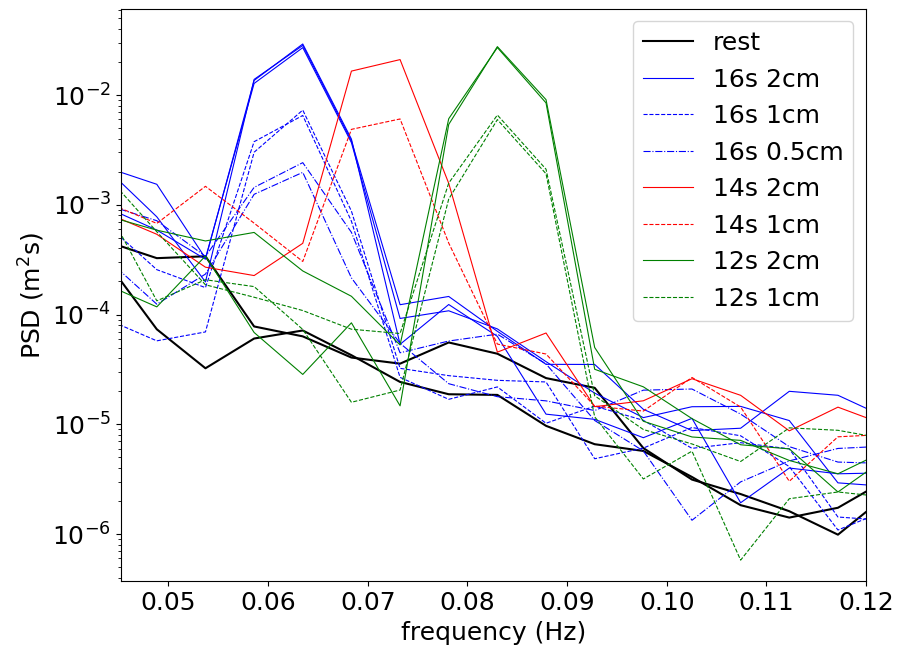
[picture p21: figure]

Figure 5. Spectra obtained when testing the instrument v2021 in the laboratory. The signal-to-noise ratio is superior or equal to 50 for all test cases, except the "extreme" test case with displacements of amplitude 0.5cm and period 16s, where the signal-to-noise ratio is around 10. The noise threshold obtained when the instrument is at rest is actually slightly better than what was obtained with the instrument v2018 (compare the present plot to Fig. 3 of Rabault et al. [52], curves "IMU 1" and "IMU 2").

Following this successful laboratory validation, we decided to perform a field valida- 452
tion experiment in the Arctic, which is described in the next subsection. | 453
3.3. 2021 NABOS expedition and comparison with SOFAR Spotter buoy in the Marginal Ice Zone 454
in the Arctic: September 2021 deployment | 455
The first field deployment opportunity for the full-feature instrument v2021 was the 456 2021 Nansen and Amundsen Basins Observational System (NABOS) expedition (https: (https://uaf-iarc.org/nabos-cruises/) 457 //uaf-iarc.org/nabos-cruises/), which was performed in the context of the ArCS II Japan- 458 Russia-Canada International Exchange Program (https://sites.google.com/edu.k.u-tokyo. 459
ac.jp/arcsii-iep-jrc/main). (https://sites.google.com/edu.k.u-tokyo.ac.jp/arcsii-iep-jrc/main) | 460
A v2021 instrument was assembled in a Zeni Lite drifting buoy, referred to Zeni- 461 v2021 in the following (see Appendix B for the buoy assembly details). This instrument 462 was deployed alongside a commercial wave measuring device (SOFAR Spotter drifting 463 buoy, https://www.sofarocean.com/products/spotter), referred to as SPOT-1386 in the 464 following. The key difference of the Spotter compared with the instrument v2021 is that 465
the Spotter measures surface displacements based on GNSS signal. | 466
On 15 September 2021, both buoys were deployed adjacent to the ice edge in the 467 central Arctic Ocean (North of the Laptev Sea), at a location of 81.915◦ N 118.763◦ E, at 468 around 05:05 UTC. The buoy deployment location is shown in Fig 6, which is overlaid 469 with 0.15 and 0.80 sea ice concentration (SIC) contours based on the Advanced Microwave 470
Scanning Radiometer 2 (AMSR2) data [63]. | 471
The two buoys drifted apart roughly 1 km within 8 hours of being deployed and 472 farther than 3 km after 24 hours. Given that the ocean surface conditions near the ice 473 edge are heterogeneous, we compared the instrument v2021 spectrum with that of SPOT- 474 1386 following the deployment, when they are still close to each other. The buoy spectra 475 compared generally well when the buoy distance was less than 1 km. The left panel in Fig 7 476 shows the buoy spectra at 08:21 15 Sep 2021, which corresponds to a moderate significant 477 wave height Hm0=1.62 m. The comparison indicates that the spectra compare well when the 478 low frequency noise, which is typical in accelerometers, is discarded. Here, the method that 479

Version February 14, 2022 submitted to Journal Not Specified | 16 of 26

was previously used in [64,65] was applied to remove this noise from Zeni-v2021 spectra. 480 An ideal filter was applied to remove data below the lowest frequency local minimum of 481 the smoothed spectrum. In addition, another spectra comparison on 08:21 16 Sep is also 482 provided on the right panel in Fig 7. By this time, the buoys were farther than 3 km apart, 483 so there is a slight difference in energy levels between the two buoys, but the general shape 484 of the spectra is comparable. These buoy spectra comparisons indicate that the instrument 485 v2021 can be used to measure ocean waves, and is a full scale, fieldwork validation of the 486
algorithms and processing used. | 487
Spotter buoys, without solar radiation recharge at high latitude during the winter 488 season, have only a short life span and SPOT-1386 ran out of battery on September 30th 489 2021. Analysis into the co-located deployment in and near the Marginal Ice Zone MIZ is 490 ongoing and will be presented in a separate, science-focused paper. Notwithstanding, a 491 comparison of wave periods (peak period Tp and spectral period T0m1) when the buoys 492 were less than 5 km apart agree within better than 5%. In addition, the part of the dataset for 493 which both instruments are frozen in the ice indicates that the noise level of the IMU-based 494 instrument (typically around 0.1cm) is much better than that of the Spotter buoy (typically 495 around 1cm), which is expected due to the different data sampling techniques used (GPS vs. 496 9dof). This provides further support that Zeni-v2021 captured consistent energy densities 497 to those of SPOT-1386, and that the Zeni-v2021 is actually better suited for measuring 498 small waves in ice. Note that the analysis into the Zeni-v2021 and SPOT-1386 co-located 499 deployment is described in a manuscript under preparation, which is why these data are 500
not released in the present technical paper. | 501
Regarding battery life, the estimated deployment duration for hourly wave sampling 502 rate was 3.3 months based on Table 1 where 2 Tadiran D-cell batteries (TL-5930/S), each 503 with 19 Ah capacity, were used as the power source. The instrument stopped transmitting, 504 likely due to empty battery, in mid-December, i.e. 3 months after the start of the deployment. 505 This corresponds well to the estimated battery life, and this is an additional confirmation 506 of the quality of the design of the hardware and software, in particular regarding the 507
implementation of low power modes. | 508

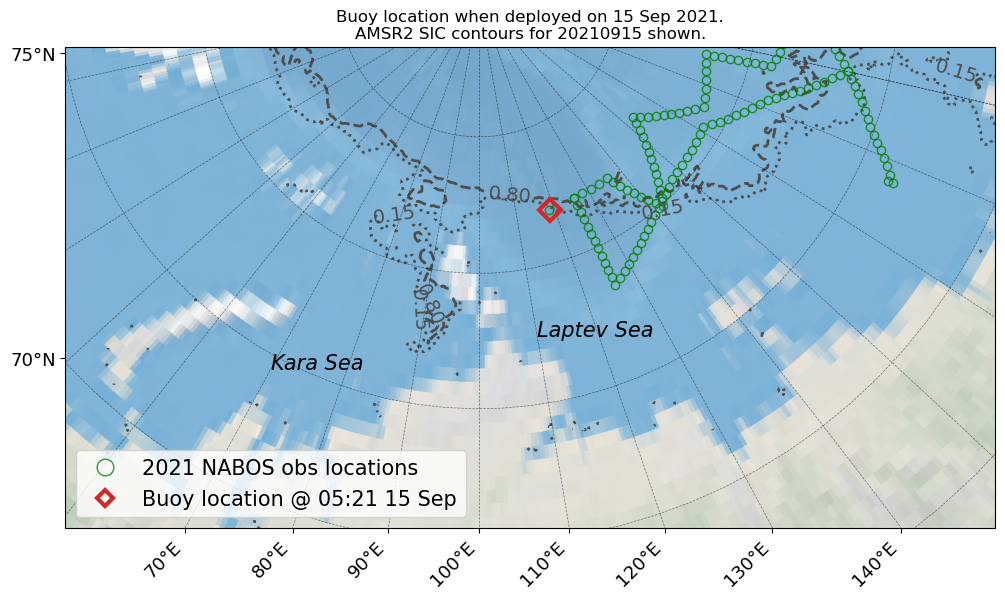
[picture p22: figure]

Figure 6. Zeni-v2021 and SPOT-1386 deployment location on 15 Sep 2021. The 2021 NABOS observation locations also shown in green markers, and AMSR2-derived 0.15 and 0.80 Sea Ice Concentration (SIC) contours for the same day are overlaid.

3.4. The "Floatenstein" drifting buoy in the Caribbeans: November 2021 | 509
A small-scale, home-produced drifting buoy was built following the v2021 design in 510 the context of the OneOcean expedition, a circumnavigation by the Norwegian tall ship 511

Version February 14, 2022 submitted to Journal Not Specified | 17 of 26

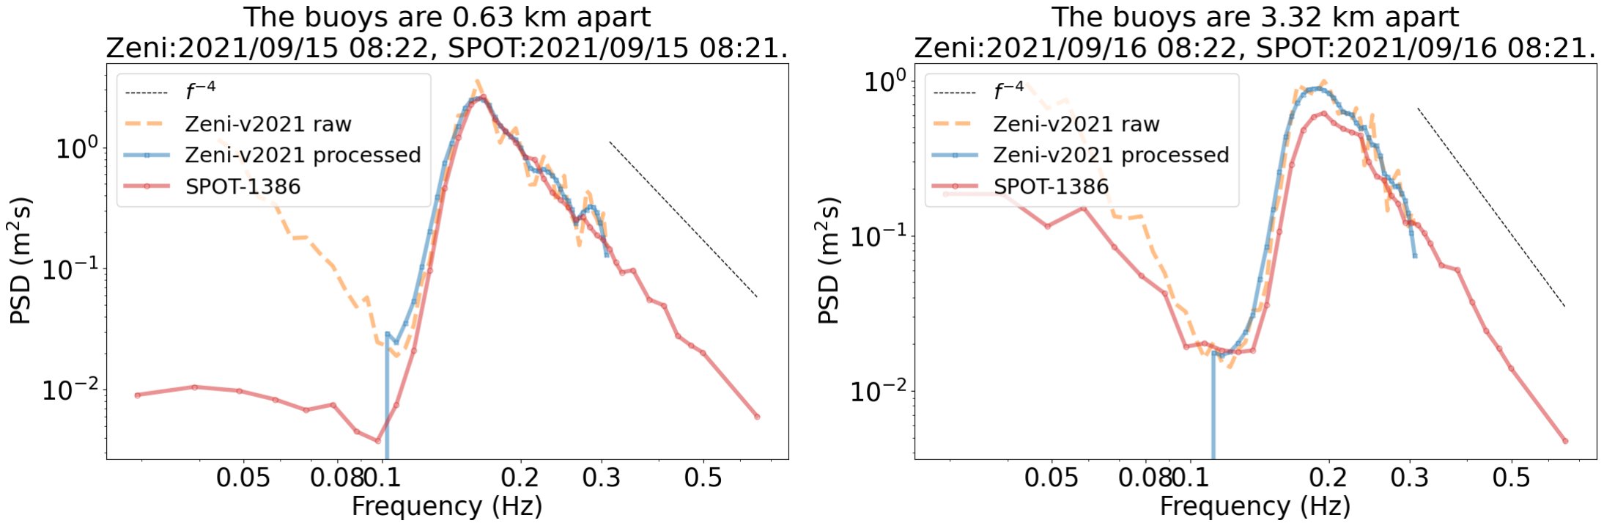
[picture p23: figure]

Figure 7. Comparison of Zeni-v2021 and SPOT-1386 spectra at 08:21 15 Sep 2021 (left) and 08:21 16 Sep 2021 (right): the distance between the buoys were roughly 1 km and 3 km, respectively. Low frequency noise of Zeni-v2021 spectra was removed by applying an ideal filter at the lowest frequency local minimum of the smoothed spectrum, similarly to what was reported in Waseda et al. [64], Nose et al. [65], which is a common post processing step when working when accelerometer-derived wave data. This indicates agreement within typically 5% between the Sofar Spotter and the instrument v2021 measurements in the open water, before the instruments drift away from each other.

Statsraad Lehmkuh. The electronics are identical to everything that was discussed above, 512 except for the battery solution used. Indeed, since the instrument had to be transported by 513 plane in the checked luggage of an expedition member, 2 traditional alkaline D-cell batteries 514 were used instead of the Li-batteries of the other instruments. A standard rectangular rigid 515 plastic enclosure of size 12cm x 12cm x 9cm was used as the main body of the buoy. Since 516 alkaline batteries are heavier than lithium batteries, this resulted in too low floatability. 517 As a consequence, we added small chunks of styrofoam (wrapped in duct tape to protect 518 from abrasion from the elements), on the sides of the rigid plastic enclosure, in order to 519 increase buoyancy. These additional buoyancy elements were set in place using cable ties 520 and glued in position using bathroom silicone sealant. In addition, the rigid plastic box 521 was fully sealed with epoxy glue, to make it fully watertight. Finally, a keel composed 522 of diverse scrap metallic parts (spare screws and bolts), packed in duct tape, was fixed 523 at the bottom of the plastic enclosure to improve its static stability. This combination of 524 disparate building materials gave a very peculiar appearance to the drifting buoy, which 525 got nicknamed humouristically as "Floatenstein" (Floating-Frankenstein). A picture of the 526
instrument, fully built before being shipped, is presented in Fig. 8. | 527
Despite its unusual appearance, Floatenstein proved to be a robust and well-functioning 528 drifter. Floatenstein was released in the open ocean on November 11th 2021, and, at the 529 time of writing this manuscript (January 2022), Floatenstein has been active for a bit over 530 two months and is working nominally. Data transmitted include i) GPS position sampled 531 each 30 minutes, and ii) vertical wave spectrum sampled each 2 hours, similar to what is 532
described in Section 2. | 533
In order to validate the good functioning of Floatenstein and the electronics inside, 534 we compare the wave data transmitted by Floatenstein with direct satellite altimeter 535 measurements. The Wavy software package (see https://github.com/bohlinger/wavy, 536 Bohlinger et al. [66]) is used to perform i) gathering of relevant satellite data, ii) collocation 537 with the position of Floatenstein, iii) extraction of relevant fields. For the collocation 538 process, the temporal and spatial constraints are 30 minutes and 50 km, respectively. Four 539 satellite missions had coinciding satellite measurements Sentinel-3A/B, Jason-3, and the 540 altimeter mounted on CFOSAT. The satellite observations are of level 3 processing quality 541 and publicly available in the Copernicus CMEMS archive¹
. | 542
Results of the comparison between Floatenstein and satellite data are presented in 543 Fig. 9. The satellite data are naturally spaced in time, due to the orbital pattern of the 544

1 https://resources.marine.copernicus.eu/product-detail/WAVE_GLO_WAV_L3_SWH_NRT_OBSERVATIONS_014_001/INFORMATION (https://resources.marine.copernicus.eu/product-detail/WAVE_GLO_WAV_L3_SWH_NRT_OBSERVATIONS_014_001/INFORMATION)

Version February 14, 2022 submitted to Journal Not Specified | 18 of 26


Figure 8. The "Floatenstein" drifting buoy. The main body of the buoy is a rectangular plastic box of dimensions 12cm x 12cm x 9cm. Due to the use of alkaline batteries instead of lithium batteries, additional floatation elements were needed. These are the two rectangular elements on the side of the main body of the buoy, which are built from styrofoam chunks, wrapped in duct tape, and held in place by cable ties. The full box is sealed with epoxy to be perfectly water tight. To avoid the need for making holes in the box, the Iridium antenna is also taped in place inside the box, immediately under the lid, pointing 45 degrees upwards. The small cubic magnet (wrapped in duct tape to hold it in position under transport), which controls the magnetic switch glued on the inside of the box, is visible on the front panel of the main body of the drifter.

satellites collecting the data. The wave statistics reported by Floatenstein lies within the 545 typical error margin of the direct observation by the satellites, which is visible as the spread 546 in significant wave height over each small transect cutting the trajectory of Floatenstein. 547 This is an additional confirmation of the good functioning of the electronics and firmware 548 of the instrument v2021, as well as an illustration that even coarse drifters are able to 549 accurately measure wave properties, as long as these are small enough to follow the motion 550 of the waves. Indeed, the amplitude of the hydrodynamic response of the buoy itself 551 is typically a fraction of the size of the buoy. This could, in theory, reach up to several 552 tens of cm for large floating buoys with a typical size of several meters as is commonly 553 found for commercially available moored system, which has, historically, created a focus on 554 developing wave buoys with a small hydrodynamic response. Our small buoy, by contrast, 555 has a typical size of 10 cm, which implies that even a "bad" hydrodynamic response, leading 556 to a displacement response in waves of several tens of percents of the buoys size, is still 557 only a few centimeters in amplitude, well below typical stochastic noise and uncertainty 558 of stochastic wave measurements in the open ocean. This is similar to other small buoys 559
developed to measure specifically the high frequency part of the wave spectrum [67]. | 560
4. Conclusion and future work | 561
This work introduces a new design of waves in ice instrument. This instrument is able 562 to perform measurements of sea ice drift using a GNSS module, and to measure waves in ice 563 up to a high degree of accuracy (the noise threshold corresponds to a significant wave height 564 of around 0.1 cm for waves with period 16 s, as demonstrated in the laboratory experiments), 565 using an inexpensive 9-degree-of-freedom sensor and extensive signal processing and noise 566 reduction techniques. In addition, this instrument costs only around slightly under 650 567 USD in electronics components (including taxes), raw materials, and assembly time, which 568 is around 10 times less expensive to build than the closest, least expensive commercial 569 alternative we know about (the Sofar Spotter buoy), while being both more sensitive and 570 much better adapted to working in the polar night, when solar input is not available. 571 Battery autonomy using a couple of Lithium D-cells is around 4.5 months, and this can 572 be easily increased by adding more cells if needed. Assembly time has been cut down to 573

Version February 14, 2022 submitted to Journal Not Specified | 19 of 26

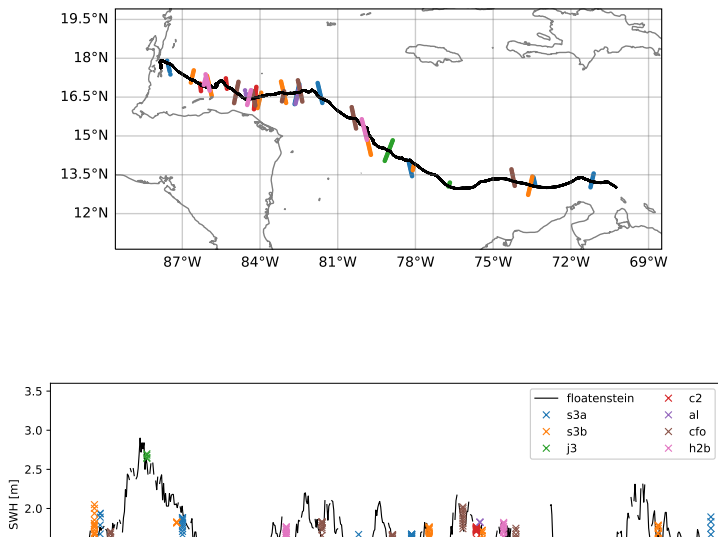
[picture p24: figure]
SWH [m]; floatenstein s3a s3b j3; c2 al cfo h2b

2021-11-21 | 2021-12-05 | 2021-12-19 | 2022-01-02

0.5

1.0

1.5

2.0

Figure 9. Top: drift pattern of Floatenstein (colored continuous black line), and satellite measurement transects (colored points) over which wave characteristics are measured by the satellites. Bottom: comparison of the Significant Wave Height (SWH), i) reported by Floatenstein (continuous black line), and ii) from satellite measurements on the corresponding measurement transects.

Version February 14, 2022 submitted to Journal Not Specified | 20 of 26

no more than typically half an hour per instrument, when building a small series of these, 574 thanks to the use of highly integrated open source development boards, and requires no 575 advanced electronics skills. The code is provided as open source together with the full 576 design blueprints and assembly instructions. Binary pre-compiled firmware versions are 577 provided for rapid upload to the electronics boards. Additional sensors can easily be added 578 to the instruments. Two-way communications are implemented through highly optimized 579 binary protocols and take place over Iridium, which enables global coverage. All data 580 measurements take place at fixed time thanks to the real time clock available on board, to 581 allow easy time synchronization, and data are buffered on board the instrument to avoid 582
data loss in case of temporary failure in establishing an iridium communication. | 583
This set of characteristics is, as a whole, and to the best of our knowledge, unrivaled by 584 any commercial or open source instrument. These drastic improvements in cost and power 585 efficiency, compared even to previous open source instruments such as the one described 586 in Rabault et al. [52], are made possible by the use of a cutting edge smartwatch processor, 587 which can handle all of the logging and data processing workloads. This is, to the best 588 of our knowledge, the fist time that such an instrument is built without the need for an 589 expensive, data-hungry embedded microcomputer, and the first time the full logging, data 590 processing, and communication workload is controlled from a single, power-efficient, low 591 cost microcontroller. In addition, this design is both modular and adapted to not only 592 measurements of sea ice drift and waves in ice, but also for open ocean measurements, as 593
we have shown in the validation section. | 594
We validated the design and signal processing code through a number of test cam- 595 paigns both in the laboratory, in the open water, and on sea ice. Results indicate agreement 596 within typically 5% with state of the art, reference instruments and measurement methods, 597 and confirm the robustness of the design as well as its power efficiency. In particular, the 598 low power consumption of the instrument (which is always challenging to get right, as 599 any error in the code or hardware design can easily increase the sleep power by a few 600 milliamps, which, while it sounds little, drains battery over time), is confirmed during 601 a deployment in the Arctic, and the accuracy of the wave measurements and wave data 602
processing code is confirmed in several test cases. | 603
This work, while purely technical, is in our opinion a groundbreaking step towards 604 bringing open source, inexpensive, easy to build, modular, power efficient instrumentation 605 to the field of in-situ study of waves in ice in particular, and oceanographic measurements 606 in general. Indeed, our design has also proven to be highly efficient both as a traditional 607 open ocean drifter and wave buoy. We expect that this design will significantly reduce the 608 barrier to entry for new research groups to monitor waves in ice, sea ice drift patterns, and 609 similarly wave activity and ocean upper layer drift and currents in the open ocean, and be a 610 possible platform for public outreach since the design is simple enough to be assembled for 611 example by high school students. This design can also be used as a basic building block for 612 setting up a variety of instruments, such as weather stations, environmental loggers, and 613 wildlife monitoring instruments, by connecting specific sensors and adding extra modules 614 to the firmware, while taking advantage of the power efficiency and iridium connectivity 615
of the main electronics board. | 616
Another key improvement brought by the present design is its very limited weight and 617 size. Typically, our implementations of the design occupy a space of 12cm x 12cm x 9cm and 618 weight between 0.3 and 0.5kg. This is small and light enough to be deployed for example 619 from a medium size quadcopter drone, or from a fishing rod several meters long. This could 620 prove very important in practice when releasing large numbers of drifters in the Arctic and 621 Antarctic, since i) changing the course of an icebreaker, and forcing it to make many (even 622 short) stops to put instrumentation on the ice, has a large footprint on the operation of the 623 ship and a high cost, while ii) flying a quadcopter drone to deploy instrumentation on the 624 ice, or dropping instrumentation on-the-go while the boat is steaming using a long rod, 625
would have a zero marginal cost for an expedition. | 626

Version February 14, 2022 submitted to Journal Not Specified | 21 of 26

As a final technical word, we want to say that, while we release the instrument design, 627 code, and validation data already now since we believe that it may already be of value for 628 other groups, there are a number of ongoing improvements that are taking place and will 629 continue also after this paper is published. First, we are working on adding the possibility 630 to store large amounts of data using a 2-step memory setup (i.e., a Ferromagnetic RAM for 631 fast, low power storing of data on the fly, and a SD card for slow long-term archiving). This 632 will make the instrument even more valuable in contexts where it can be recovered after 633 deployment, since this will allow to store and recover time series that are, at present, only 634 stored temporarily in RAM for performing wave spectrum computation. Second, we will 635 work in the future on adding full directional wave spectrum information. Finally, when 636 these additions are done, a major code rewrite, taking into account all the lessons learnt 637 while developing this instrument, will be performed to make the code even easier to extend, 638 test, and reuse. When these further refinements are implemented, we will also consider 639 designing an open source printed circuit board, to lower even further the amount of work 640 needed to assemble the electronics of the instrument. Ultimately, if there is interest from the 641 community, we hope to provide an all-in-one, fully integrated, low cost electronics boards 642
that will be a true turn-key solution. | 643

Author Contributions: Conceptualization, JR and TN and MM and ØB and JV and LRH and TW 644 and MJ and GS and MJ and KHC and AG and AJ and OG and AM and AB; methodology, JR and TN 645 and; software, JR and GH and PB; validation, JR and TN and MM and ØB and JV and LRH and PB 646 and TK and TK; formal analysis, JR and TN and PB; investigation, JR and TN and MM and LRH and; 647 resources, MM and ØB and LRH and TW and MJ and KHC and AB; data curation, JR and TN and 648 PB; writing JR; visualization, JR and TN and PB; funding acquisition, JR and MM and ØB and TW 649 and MJ and KHC and AJ and AM and AB. All authors have read and agreed to the published version 650
of the manuscript. | 651

Funding: This work was funded by the Research Council of Norway through ThinTEC (project 652 number A321200), Norwegian Polar Institute through ThinIce (project number 66017), the ArCS 653 II Japan-Russia-Canada International Exchange Program, the Arctic Challenge for Sustainability II 654 Project (ArCS II Project, Program Grant Number JPMXD1420318865), the JSPS KAKENHI Grant 655 Number JP 19H00801, 19H05512, and 21K14357, the DOFI Petromaks II project (funding to the 656
University of Oslo, by the Research Council of Norway funding, grant number 28062). | 657
Data Availability Statement: Available by request to the corresponding author. | 658

Acknowledgments: We want to thank Pr. Frank Nilsen and Pr. Ilker Fer for inviting us to join the 659 Nansen Legacy Cruise PC-2: Winter Process Cruise, during which we tested the first early prototypes 660 of the v2021. Our warmest thanks go to all the participants of this cruise and to the crew of the R/V 661 Kronprins Haakon for their help during this cruise and the very friendly weeks spent together on 662 board the ship. Our warmest thanks go to Ceslav Czyz, Zoe Koenig, and Helge Bryhni, for many 663 interesting discussions about the development of custom made software and hardware for geoscience 664
measurements. | 665
We also want to thank the Norwegian Meteorological Institute for continuous support of 666 our efforts towards building an open source instrumentation community, and for support of our 667 open source release policy. This work was supported partly through several projects, in particular, 668 ThinTEC (project number A321200), ThinIce (project number 66017), funded by the Research Council 669 of Norway and the Norwegian Polar Institute. Participation to the Nansen Legacy PC-2 cruise 670 and instrumentation used there, as well as part of the data analyzis, were funded through Nansen 671 Legacy project (NFR-276730) and FOCUS project (NFR- 301450). In addition, some synergies with the 672 Machine Ocean project funded by the research Council of Norway (project number 303411) helped in 673
the present developments. | 674
We gratefully acknowledge support from the Japan Agency for Marine-Earth Science and Tech- 675 nology, in particular, for constructing the ice-wave tank at the Univ. of Tokyo. The 2021 NABOS buoy 676 deployment was supported by the ArCS II Japan-Russia-Canada International Exchange Program 677 (https://sites.google.com/edu.k.u-tokyo.ac.jp/arcsii-iep-jrc/main). TW is grateful to Dr Tatiana 678 Alekseeva of Russian Arctic and Antarctic Research Institute for making our NABOS deployment pos- 679 sible. TN, TW, TKo, and TKa are grateful to Profs Kanna and Tateyama for deploying our wave buoys 680 during 2021 NABOS expedition. Some of this work was performed in the the context of the Arctic 681

Version February 14, 2022 submitted to Journal Not Specified | 22 of 26

Challenge for Sustainability II Project (ArCS II Project, Program Grant Number JPMXD1420318865). A 682 part of this study was also conducted under JSPS KAKENHI Grant Number JP 19H00801, 19H05512, 683 and 21K14357. This study was supported partly by the Grant for Joint Research Program of the Japan 684
Arctic Research Network Center. | 685
We also want to thank the One Ocean expedition and the University of Bergen course SDG313 686 for facilitating deployment of the Floatenstein drifter in the Caribbean. This work was also partially 687 done in the context of the DOFI Petromaks II project (funding to the University of Oslo, by the 688
Research Council of Norway, grant number 28062). | 689
We want to thank Jim Thomson, as well as the members of his group, for very interesting and 690 stimulating discussions about open source instrumentation and measurements of ocean waves using 691
open source electronics. | 692
Finally, we want to acknowledge and thank the Arduino community and ecosystem, as well 693 as Sparkfun and the community around it, for making high performance microelectronics easily 694 available to non experts. Our development of open source instrumentation as is presented in this 695
work would not be possible without the amazing work and tools offered by these communities. | 696
Conflicts of Interest: No conflict of interest. | 697
Appendix A: open source release and founding of an open source community | 698
All the code, instructions, and post processing scripts necessary to build, program, and 699 use the instrument v2021, are available as open source hardware and software on Github 700 under a MIT license at the following URL: https://github.com/jerabaul29/OpenMetBuoy- 701
v2021a. (https://github.com/jerabaul29/OpenMetBuoy-v2021a) | 702
Appendix B: Zeni-v2021 assembly for the 2021 NABOS cruise | 703
The Artemis Global Tracker and other electronics components listed in Section 2.1 704 were enclosed in a water resistant Takachi box as shown in Fig 1. Deployment in the 705 open water requires a floating enclosure that is durable and watertight. For our purpose, 706 we used a commercial Zeni Lite drifting buoy (https://www.zenilite.co.jp/prod/new- (https://www.zenilite.co.jp/prod/new-chikuden.html) 707 chikuden.html), (https://www.zenilite.co.jp/prod/new-chikuden.html) that was purchased by the University of Tokyo several years ago, as the 708 floating enclosure. Images of the floating enclosure setup are shown in Fig 2. The Zeni 709 Lite drifting buoy has open space inside where the Takachi box was fixed. This space was 710 easily accessible, and it is also high enough for the antenna to be fixed on the upper half of 711 the buoy. The water tightness is achieved via an O-ring placed underneath the blue plate. 712 When the steel brace is fastened, pressure is evenly applied around the buoy housing where 713 the top and bottom parts of the buoy are joined. The instrument v2021 that was deployed 714 in the Arctic Ocean as described in Section 3.3, is referred to as Zeni-v2021 in the main text, 715 because the instrument v2021 was assembled in the Zeni Lite drifting buoy enclosure. 716

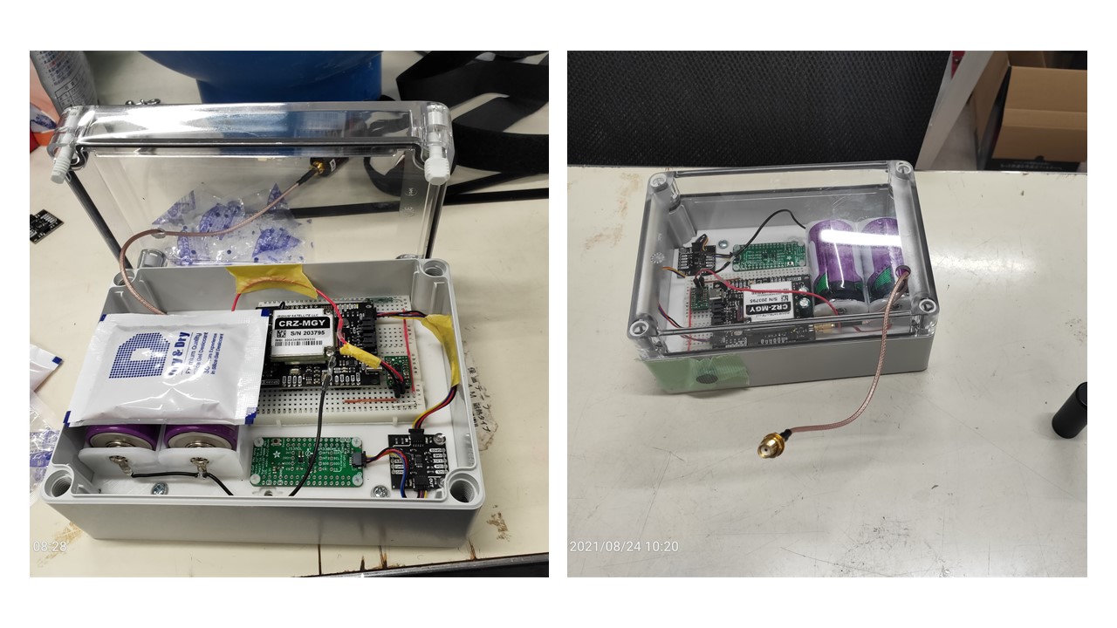
[picture p25: figure]

Figure 1. Illustrations of the instrument v2021 electronics components enclosed in a water resistant Takachi box.

Version February 14, 2022 submitted to Journal Not Specified | 23 of 26

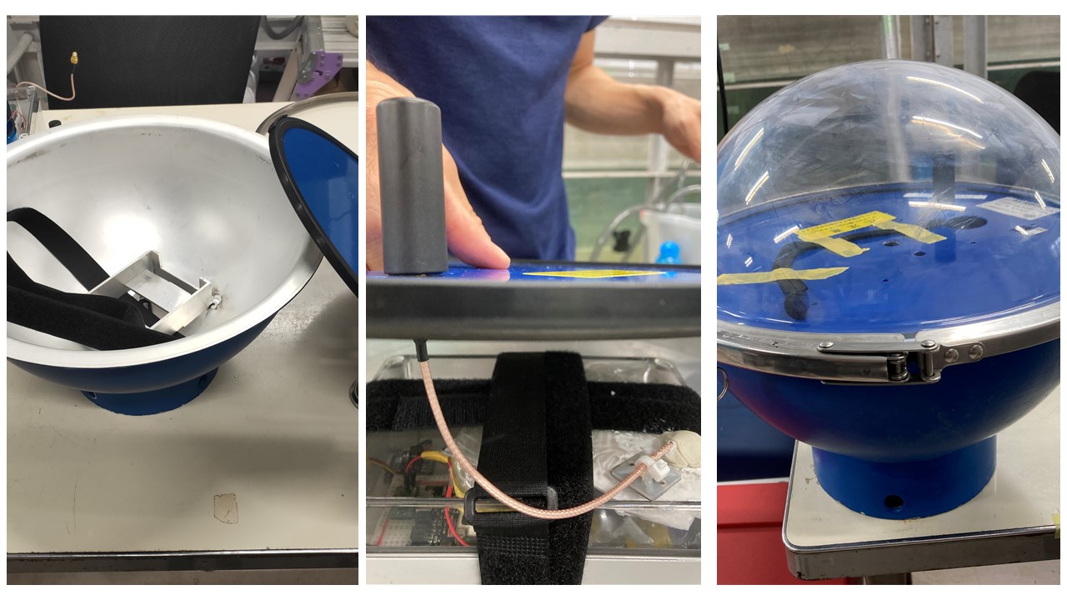
[picture p26: figure]

Figure 2. Illustrations of Zeni Lite drifting buoy being used as a floating housing. The left image shows the bottom part of the buoy where the Takachi box was fixed. The middle image shows how the antenna was attached through the blue plate. The right image shows the assembled Zeni-v2021.

717

Version February 14, 2022 submitted to Journal Not Specified | 24 of 26
References | 718
1. | Squire, V.A. Ocean wave interactions with sea ice: a reappraisal. Annual Review of Fluid Mechanics 2020, 52, 37–60. | 719
2. | Smith, F.; Korobkin, A.; Parau, E.; Feltham, D.; Squire, V. Modelling of sea-ice phenomena, 2018. | 720
3. Zhao, X.; Shen, H.H. Three-layer viscoelastic model with eddy viscosity effect for flexural-gravity wave propagation through ice 721
| cover. Ocean Modelling 2018, 131, 15–23. | 722
4. Golden, K.M.; Bennetts, L.G.; Cherkaev, E.; Eisenman, I.; Feltham, D.; Horvat, C.; Hunke, E.; Jones, C.; Perovich, D.K.; Ponte- 723
| Castaneda, P.; et al. Modeling sea ice. Notices of the American Mathematical Society 2020, 67. | 724
5. Roach, L.A.; Bitz, C.M.; Horvat, C.; Dean, S.M. Advances in modeling interactions between sea ice and ocean surface waves. 725
| Journal of Advances in Modeling Earth Systems 2019, 11, 4167–4181. | 726
6. Sutherland, G.; Rabault, J.; Christensen, K.H.; Jensen, A. A two layer model for wave dissipation in sea ice. Applied Ocean Research 727
| 2019, 88, 111–118. | 728
7. Williams, T.D.; Rampal, P.; Bouillon, S. Wave–ice interactions in the neXtSIM sea-ice model. The Cryosphere 2017, 11, 2117–2135. 729
8. Sree, D.K.; Law, A.W.K.; Shen, H.H. An experimental study of gravity waves through segmented floating viscoelastic covers. 730
| Applied Ocean Research 2020, 101, 102233. | 731
9. Rabault, J.; Sutherland, G.; Jensen, A.; Christensen, K.H.; Marchenko, A. Experiments on wave propagation in grease ice: 732
| combined wave gauges and particle image velocimetry measurements. Journal of Fluid Mechanics 2019, 864, 876–898. | 733
10. Li, H.; Gedikli, E.D.; Lubbad, R. Laboratory study of wave-induced flexural motion of ice floes. Cold Regions Science and Technology 734
| 2021, 182, 103208. | 735
11. Sutherland, G.; Halsne, T.; Rabault, J.; Jensen, A. The attenuation of monochromatic surface waves due to the presence of an 736
| inextensible cover. Wave motion 2017, 68, 88–96. | 737
12. Sree, D.K.; Law, A.W.K.; Shen, H.H. An experimental study of gravity waves through segmented floating viscoelastic covers. 738
| Applied Ocean Research 2020, 101, 102233. doi:https://doi.org/10.1016/j.apor.2020.102233. (https://doi.org/https://doi.org/10.1016/j.apor.2020.102233) | 739
13. Marchenko, A.; Haase, A.; Jensen, A.; Lishman, B.; Rabault, J.; Evers, K.U.; Shortt, M.; Thiel, T. Laboratory Investigations of the 740 Bending Rheology of Floating Saline Ice and Physical Mechanisms of Wave Damping In the HSVA Hamburg Ship Model Basin 741
| Ice Tank. Water 2021, 13, 1080. | 742
14. Kohout, A.L.; Smith, M.; Roach, L.A.; Williams, G.; Montiel, F.; Williams, M.J.M. Observations of exponential wave attenuation in 743
| Antarctic sea ice during the PIPERS campaign. Annals of Glaciology 2020, 61, 196–209. doi:10.1017/aog.2020.36. (https://doi.org/10.1017/aog.2020.36) | 744
15. Voermans, J.J.; Rabault, J.; Filchuk, K.; Ryzhov, I.; Heil, P.; Marchenko, A.; Collins III, C.O.; Dabboor, M.; Sutherland, G.; Babanin, 745 A.V. Experimental evidence for a universal threshold characterizing wave-induced sea ice break-up. The Cryosphere 2020, 746
| 14, 4265–4278. | 747
16. Løken, T.K.; Rabault, J.; Jensen, A.; Sutherland, G.; Christensen, K.H.; Müller, M. Wave measurements from ship mounted sensors 748
| in the Arctic marginal ice zone. Cold Regions Science and Technology 2021, 182, 103207. | 749
17. Thomson, J.; Fan, Y.; Stammerjohn, S.; Stopa, J.; Rogers, W.E.; Girard-Ardhuin, F.; Ardhuin, F.; Shen, H.; Perrie, W.; Shen, H.; et al. 750
| Emerging trends in the sea state of the Beaufort and Chukchi seas. Ocean Modelling 2016, 105, 1–12. | 751
18. Løken, T.K.; Marchenko, A.; Ellevold, T.J.; Rabault, J.; Jensen, A. An investigation into the turbulence induced by moving ice floes. 752
| arXiv preprint arXiv:2104.02378 2021. | 753
19. Løken, T.K.; Ellevold, T.J.; de la Torre, R.G.R.; Rabault, J.; Jensen, A. Bringing optical fluid motion analysis to the field: a 754 methodology using an open source ROV as a camera system and rising bubbles as tracers. Measurement Science and Technology 755
| 2021, 32, 095302. | 756
20. Voermans, J.J.; Liu, Q.; Marchenko, A.; Rabault, J.; Filchuk, K.; Ryzhov, I.; Heil, P.; Waseda, T.; Nose, T.; Kodaira, T.; et al. 757 Wave dispersion and dissipation in landfast ice: comparison of observations against models. The Cryosphere 2021, 2021, 1–26. 758
| doi:10.5194/tc-2021-210. (https://doi.org/10.5194/tc-2021-210) | 759
21. Sutherland, G.; Rabault, J. Observations of wave dispersion and attenuation in landfast ice. Journal of Geophysical Research: Oceans 760
| 2016, 121, 1984–1997. | 761
22. Rabault, J.; Sutherland, G.; Gundersen, O.; Jensen, A. Measurements of wave damping by a grease ice slick in Svalbard using 762
| off-the-shelf sensors and open-source electronics. Journal of Glaciology 2017, 63, 372–381. | 763
23. Marchenko, A.; Rabault, J.; Sutherland, G.; Collins, C.O.; Wadhams, P.; Chumakov, M. Field observations and preliminary 764 investigations of a wave event in solid drift ice in the Barents Sea. Proceedings-International Conference on Port and Ocean 765
| Engineering under Arctic Conditions. Port and Ocean Engineering under Arctic Conditions, 2017. | 766
24. Marchenko, A.; Wadhams, P.; Collins, C.; Rabault, J.; Chumakov, M. Wave-ice interaction in the north-west barents sea. Applied 767
| Ocean Research 2019, 90, 101861. | 768
25. Johnson, M.A.; Marchenko, A.V.; Dammann, D.O.; Mahoney, A.R. Observing Wind-Forced Flexural-Gravity Waves in the 769
| Beaufort Sea and Their Relationship to Sea Ice Mechanics. Journal of Marine Science and Engineering 2021, 9, 471. | 770
26. Herman, A.; Evers, K.U.; Reimer, N. Floe-size distributions in laboratory ice broken by waves. The Cryosphere 2018, 12, 685–699. 771
27. Horvat, C.; Tziperman, E. The evolution of scaling laws in the sea ice floe size distribution. Journal of Geophysical Research: Oceans 772
| 2017, 122, 7630–7650. | 773
28. Herman, A. Sea-ice floe-size distribution in the context of spontaneous scaling emergence in stochastic systems. Physical Review E 774
| 2010, 81, 066123. | 775
29. Herman, A. Spectral wave energy dissipation due to under-ice turbulence. Journal of Physical Oceanography 2021, 51, 1177–1186. 776

Version February 14, 2022 submitted to Journal Not Specified | 25 of 26
30. Voermans, J.; Babanin, A.; Thomson, J.; Smith, M.; Shen, H. Wave attenuation by sea ice turbulence. Geophysical Research Letters 777
2019, 46, 6796–6803. | 778
31. Smith, M.; Thomson, J. Pancake sea ice kinematics and dynamics using shipboard stereo video. Annals of Glaciology 2020, 61, 1–11. 779
32. Herman, A. Wave-Induced Surge Motion and Collisions of Sea Ice Floes: Finite-Floe-Size Effects. Journal of Geophysical Research: 780
Oceans 2018, 123, 7472–7494. | 781
33. Herman, A.; Wenta, M.; Cheng, S. Sizes and shapes of sea ice floes broken by waves–a case study from the East Antarctic coast. 782
Frontiers in Earth Science 2021, 9, 390. | 783
34. Li, J.; Babanin, A.V.; Liu, Q.; Voermans, J.J.; Heil, P.; Tang, Y. Effects of Wave-Induced Sea Ice Break-Up and Mixing in a 784
High-Resolution Coupled Ice-Ocean Model. Journal of Marine Science and Engineering 2021, 9, 365. | 785
35. Ardhuin, F.; Otero, M.; Merrifield, S.; Grouazel, A.; Terrill, E. Ice breakup controls dissipation of wind waves across Southern 786
Ocean sea ice. Geophysical Research Letters 2020, 47, e2020GL087699. | 787
36. Herman, A. Wave-induced stress and breaking of sea ice in a coupled hydrodynamic discrete-element wave–ice model. The 788
Cryosphere 2017, 11, 2711–2725. | 789
37. Roach, L.A.; Horvat, C.; Dean, S.M.; Bitz, C.M. An emergent sea ice floe size distribution in a global coupled ocean-sea ice model. 790
Journal of Geophysical Research: Oceans 2018, 123, 4322–4337. | 791
38. Horvat, C.; Tziperman, E. A prognostic model of the sea-ice floe size and thickness distribution. The Cryosphere 2015, 9, 2119–2134. 792
39. Mosig, J.E.M.; Montiel, F.; Squire, V.A. Comparison of viscoelastic-type models for ocean wave attenuation in ice-covered seas. 793
Journal of Geophysical Research: Oceans 2015, 120, 6072–6090. doi:https://doi.org/10.1002/2015JC010881. (https://doi.org/https://doi.org/10.1002/2015JC010881) | 794
40. Cheng, S.; Rogers, W.E.; Thomson, J.; Smith, M.; Doble, M.J.; Wadhams, P.; Kohout, A.L.; Lund, B.; Persson, O.P.; Collins III, C.O.; 795 et al. Calibrating a Viscoelastic Sea Ice Model for Wave Propagation in the Arctic Fall Marginal Ice Zone. Journal of Geophysical 796
Research: Oceans 2017, 122, 8770–8793. doi:https://doi.org/10.1002/2017JC013275. (https://doi.org/https://doi.org/10.1002/2017JC013275) | 797
41. Kohout, A.L.; Penrose, B.; Penrose, S.; Williams, M.J. A device for measuring wave-induced motion of ice floes in the Antarctic 798
marginal ice zone. Annals of Glaciology 2015, 56, 415–424. | 799
42. Rabault, J.; Sutherland, G.; Ward, B.; Christensen, K.H.; Halsne, T.; Jensen, A. Measurements of waves in landfast ice using 800
inertial motion units. IEEE Transactions on Geoscience and Remote Sensing 2016, 54, 6399–6408. | 801
43. Thomson, J.; Gemmrich, J.; Rogers, W.E.; Collins, C.O.; Ardhuin, F. Wave Groups Observed in Pancake Sea Ice. Journal of 802
Geophysical Research: Oceans 2019, 124, 7400–7411. doi:https://doi.org/10.1029/2019JC015354. (https://doi.org/https://doi.org/10.1029/2019JC015354) | 803
44. Kodaira, T.; Waseda, T.; Nose, T.; Sato, K.; Inoue, J.; Voermans, J.; Babanin, A. Observation of on-ice wind waves under 804 grease ice in the western Arctic Ocean. Polar Science 2021, 27, 100567. Arctic Challenge for Sustainability Project (ArCS), 805
doi:https://doi.org/10.1016/j.polar.2020.100567. (https://doi.org/https://doi.org/10.1016/j.polar.2020.100567) | 806
45. Ardhuin, F.; Stopa, J.; Chapron, B.; Collard, F.; Smith, M.; Thomson, J.; Doble, M.; Blomquist, B.; Persson, O.; Collins, C.O.; et al. 807 Measuring ocean waves in sea ice using SAR imagery: A quasi-deterministic approach evaluated with Sentinel-1 and in situ data. 808
Remote Sensing of Environment 2017, 189, 211–222. doi:https://doi.org/10.1016/j.rse.2016.11.024. (https://doi.org/https://doi.org/10.1016/j.rse.2016.11.024) | 809
46. Horvat, C.; Blanchard-Wrigglesworth, E.; Petty, A. Observing waves in sea ice with ICESat-2. Geophysical Research Letters 2020, 810
47, e2020GL087629. | 811
47. Smit, P.; Houghton, I.; Jordanova, K.; Portwood, T.; Shapiro, E.; Clark, D.; Sosa, M.; Janssen, T. Assimilation of significant wave 812
height from distributed ocean wave sensors. Ocean Modelling 2021, 159, 101738. | 813
48. Doble, M.; Mercer, D.J.; Meldrum, D.; Peppe, O.C. Wave measurements on sea ice: developments in instrumentation. Annals of 814
Glaciology 2006, 44, 108–112. | 815
49. Datawell Corporation. History of Datawell 2001. | 816
50. Raghukumar, K.; Chang, G.; Spada, F.; Jannsen, T. Directional Spectrum Measurements by the Spotter: a new Developed Wave 817
Buoy 2019. | 818
51. Wilkinson, J.; Wadke, P.; Meldrum, D.; Mercer, D.; Doble, M.; Wadhams, P. The autonomous measurement of waves propagating 819
across the Arctic Ocean. OCEANS 2007. IEEE, 2007, pp. 1–7. | 820
52. Rabault, J.; Sutherland, G.; Gundersen, O.; Jensen, A.; Marchenko, A.; Breivik, Ø. An open source, versatile, affordable waves in 821
ice instrument for scientific measurements in the Polar Regions. Cold Regions Science and Technology 2020, 170, 102955. | 822
53. Sutherland, G.; Aguiar, V.; Hole, L.R.; Rabault, J.; Dabboor, M.; Breivik, Ø. Determining an optimal transport velocity in the 823
marginal ice zone using operational ice-ocean prediction systems. ArXiv 2021. | 824
54. Thomson, J. Wave breaking dissipation observed with “SWIFT” drifters. Journal of Atmospheric and Oceanic Technology 2012, 825
29, 1866–1882. | 826
55. Keating, D. Fetch-limited wave growth in Nootka Sound 2016. | 827
56. Thomson, J.; Moulton, M.; de Klerk, A.; Talbert, J.; Guerra, M.; Kastner, S.; Smith, M.; Schwendeman, M.; Zippel, S.; Nylund, S. 828 A new version of the SWIFT platform for waves, currents, and turbulence in the ocean surface layer. 2019 IEEE/OES Twelfth 829
Current, Waves and Turbulence Measurement (CWTM). IEEE, 2019, pp. 1–7. | 830
57. Defense Advanced Research Projects Agency. Ocean of Things. Web page, 2021. | 831
58. Ambiq Inc.. Ambiq Apollo3 BLU microcontroller. Web page, 2021. | 832
59. Sparkfun Inc.. Artemis Global Tracker. Web page, 2021. | 833
60. Pololu Inc.. Pololu 3.3V Step-Up/Step-Down Voltage Regulator S7V8F3. Web page, 2021. | 834
61. Mouser Inc.. MDRR-DT-15-25-F Reed switch. Web page, 2021. | 835

Version February 14, 2022 submitted to Journal Not Specified | 26 of 26
62. Nilsen, F.; Fer, I.; Baumann, T.M.; Breivik, Ø.; Czyz, C.; Frank, L.; Kalhagen, K.; Koenig, Z.; Kolås, E.H.; Kral, S.T.; et al. PC-2 836
Winter Process Cruise (WPC): Cruise Report. The Nansen Legacy Report Series 2021. | 837
63. Hori, M.; Yabuki, H.; Sugimura, T.; Terui, T. AMSR2 Level 3 product of Daily Polar Brightness Temperatures and Product, 1.00, 838
2012. [Date accessed 23. Jul. 2019]. | 839
64. Waseda, T.; Webb, A.; Sato, K.; Inoue, J. Arctic Wave Observation by Drifting Type Wave Buoys in 2016. The 27th International 840
Ocean and Polar Engineering Conference; International Society of Offshore and Polar Engineers, , 2017. | 841
65. Nose, T.; Webb, A.; Waseda, T.; Inoue, J.; Sato, K. Predictability of storm wave heights in the ice-free Beaufort Sea. Ocean Dynamics 842
2018, 68, 1383–1402. https://doi.org/10.1007/s10236-018-1194-0. | 843
66. Bohlinger, P.; Øyvind Breivik.; Economou, T.; Müller, M. A novel approach to computing super observations for probabilistic 844
wave model validation. Ocean Modelling 2019, 139, 101404. doi:https://doi.org/10.1016/j.ocemod.2019.101404. (https://doi.org/https://doi.org/10.1016/j.ocemod.2019.101404) | 845
67. Yurovsky, Y.Y.; Dulov, V.A. MEMS-based wave buoy: Towards short wind-wave sensing. Ocean Engineering 2020, 217, 108043. | 846
