jerabaul29/OpenMetBuoy-v2021a/instrument_hardware/jpg/buoy_bottom.jpg

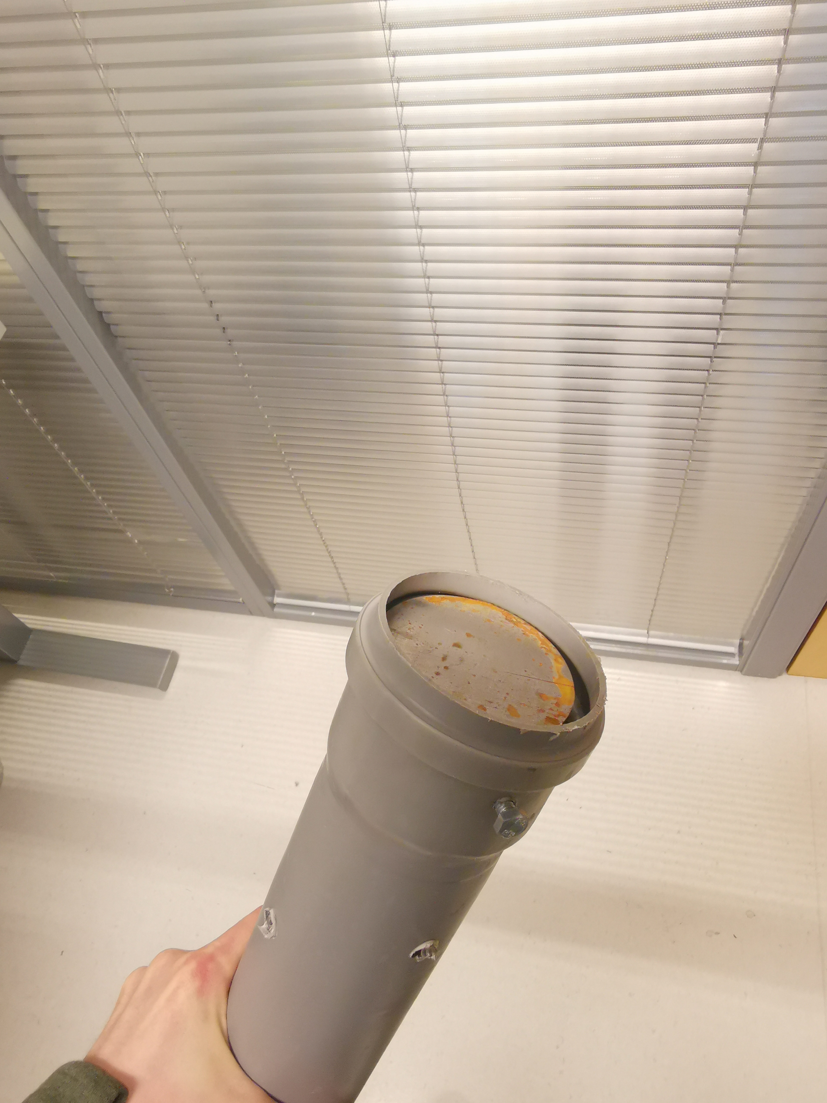
instrument_hardware/jpg/buoy_bottom.jpg
