jerabaul29/OpenMetBuoy-v2021a/instrument_hardware/jpg/buoy_from_top.jpg

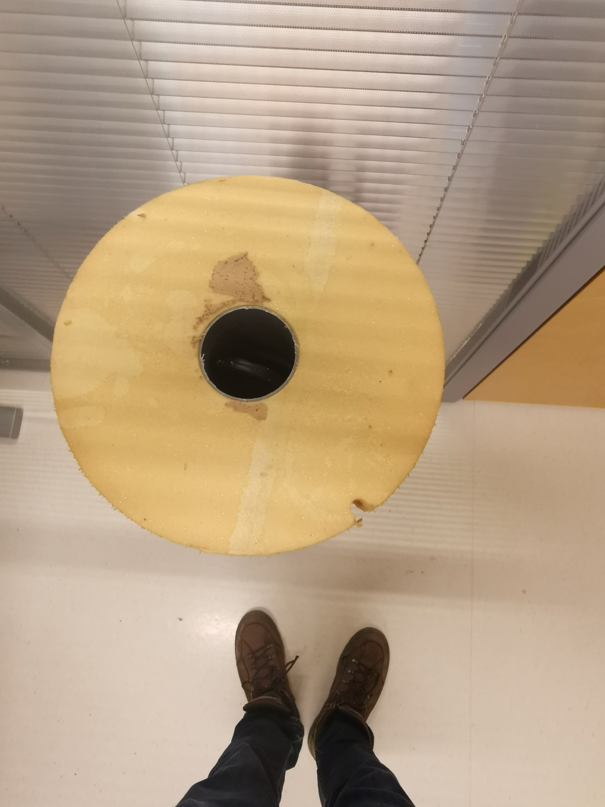
instrument_hardware/jpg/buoy_from_top.jpg
