jerabaul29/OpenMetBuoy-v2021a/instrument_hardware/jpg/from_top.jpg

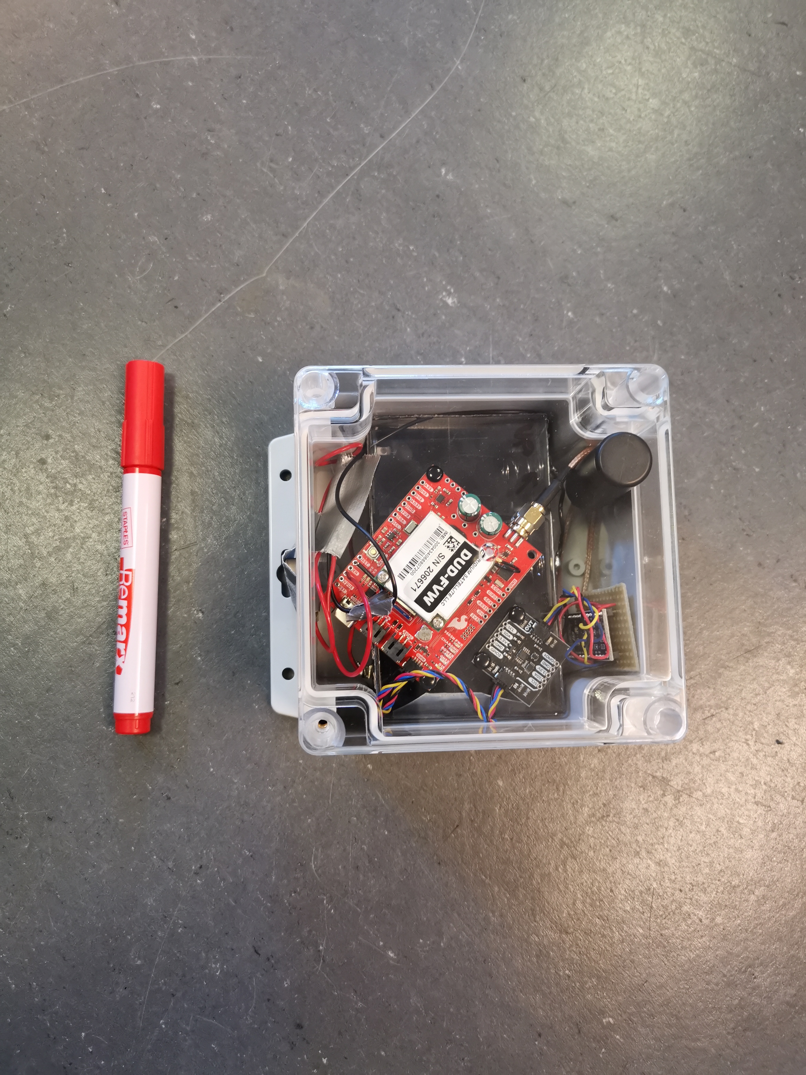
instrument_hardware/jpg/from_top.jpg
