jerabaul29/OpenMetBuoy-v2021a/end_user_manual/LabMaker_OMB_instructions.md

# LabMaker OMB instructions

A few user instructions adapted specifically for users who bought a LabMaker OMB: https://www.labmaker.org/collections/earth-and-ecology/products/openmetbuoy .

## High level guidelines

Keep in mind the following to avoid damaging your OMB:

- Never feed power from 2 sources at the same time: either have batteries inserted, or connect the OMB to your computer with USB-C, but never do both at the same time
- Never turn on the OMB without having the antenna connected: RF modules turned on without an antenna may be damaged by energy reflections
- Be careful about Electro Static Discharge (ESD): even small electrostatic discharges that you do not feel as a human may be enough to damage electronics. Ideally use an ESD-safe workplace (as is typically found in electronics workshops), or at least try to avoid using clothes that create a lot of static electricity, and make sure to touch a large grounded metal mass (such as a sink) before touching electronics

## Extras needed

You will need a couple of extras for using the OMB from Labmaker:

- batteries are not included; you will need SAFT LSH20 batteries (2x in parallel; make sure to follow the polarity indicated on the battery holders + PCB). Other D-cell-format, Lithium 3.6V batteries may work, but this comes without guarantee from us (and make sure if you use another kind / supplier of Li batteries to use batteries that these are 3.6V, and can provide enough current - at least up to around 200mA in bursts)
- to make the OMB fully watertight, we recommend using "marine grade silicone" (or if hard to source, "bathroom silicone" is usually enough) to seal the box once the batteries are inserted
- we recommend inserting "dessiccant bags" before sealing the boxes to make sure there is no humidity / condensation happening when there are temperature changes.

## Instructions

Please read the following to get a general overview of the OMB use:

https://github.com/jerabaul29/OpenMetBuoy-v2021a/tree/main/end_user_manual

Quick walkthrough:

- (facultative) upload the exact firmware version you want
  - the instrument should come from LabMaker with the correct firmware. However, you can easily re-upload the firmware yourself, in case you want to tune or modify the firmware, and / or to make sure the exact version you want is used. For this:
    - install the GUI programming tool: see https://github.com/jerabaul29/OpenMetBuoy-v2021a/blob/main/development_environment/setup_arduino_v1-8_environment/Instructions.md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 for instructions and / or instructions at https://github.com/sparkfun/Artemis-Firmware-Upload-GUI . (depending on your platform, you may need a bit of extra setup, such as registering to the ```dialout``` group on Linux: see : https://arduino.stackexchange.com/questions/74714/arduino-dev-ttyusb0-permission-denied-even-when-user-added-to-group-dialout-o .
    - remove batteries from the OMB
    - connect the OMB to your computer over USB-C
    - upload the firmware you want; we recommend using https://github.com/jerabaul29/OpenMetBuoy-v2021a/blob/main/legacy_firmware/binaries/steval_gps30mins_waves2hr_drifter.bin ; if you want other parameters (frequency of GPS / wave logging), feel free to ask for it in a new issue at https://github.com/jerabaul29/OpenMetBuoy-v2021a/issues .
    - test the instrument: put it outside after setting up the Rock7 account (see next point), or just let it running connected over USB-C and check the serial output (see https://github.com/jerabaul29/OpenMetBuoy-v2021a/tree/main/end_user_manual#checking-operation-through-serial )
- prepare the Rock7 account and data collection: see https://github.com/jerabaul29/OpenMetBuoy-v2021a/tree/main/end_user_manual#receiving-the-iridium-messages .
- test and seal: we recommend to i) install batteries and put a dessiccant bag, ii) screw the lid, iii) put outside and do a test for a day to check messages are received as expected and the instrument works. Once this is done and it is confirmed that the instrument works well, seal it with bathroom silicon to make it 100% watertight; put the magnet and make sure the instrument is switched off.
- deploy: to deploy, all you need to do is remove the magnet and the instrument will turn on. Remember to have an active Rock7 subscription and enough credits!

## Decoding messages and communicating with Rock7 servers

See the materials at: https://github.com/jerabaul29/OpenMetBuoy-v2021a/tree/main/legacy_firmware/utils .

## Estimating autonomy + cost

To estimate battery autonomy + iridium costs, see respectively:

- https://arxiv.org/pdf/2201.08384.pdf Table 1 + caption
- https://arxiv.org/pdf/2201.08384.pdf Table 3 + caption

You may need to adapt depending on the exact GPS and wave measurement frequency you use. Note that the published paper https://www.mdpi.com/2076-3263/12/3/110 contains a lot less information on these aspects (a reviewer asked us to remove the details from the paper as they found these too technical; don't be this reviewer, let users include technical description into their paper when they think user will need it (i.e. we regularly receive request for more detailed explanations about how the power consumption can be estimated, and have to refer the readers to the preprint initially submitted, as the details were removed from the paper following a request from the reviewer)!), so refer to the preprint above for these calculations!

## Quick web overview

If you want access to a quick web overview such as:

wavebug

Take contact at jean.rblt@gmail.com for more information and to have your buoys registered in our system.

## Commonly encountered issues

- on  Linux, you may need to be in the dialout group to access usb port; for more information, see: https://support.arduino.cc/hc/en-us/articles/360016495679-Fix-port-access-on-Linux

## Taking contact

In case of any question, open an issue on the present GH repository to get help: https://github.com/jerabaul29/OpenMetBuoy-v2021a/issues .

## Issues with LabMaker buoys

When using labmaker buoys, I have noticed over the time several small issues - these are usually very easy to fix, but if not fixed, the buoy will not work. See in order of frequency:

- Wrong firmware installed: this has happened several times, just re-flash the right firmware. Remember to do so when batteries are not inserted, to avoid feeding power from 2 sources at the same time.
- missing qwiic cable: there should be a SF qwiic cable going from the AGT to the qwiic switch (side "IN"); on some buoys, this has been forgotten - just put a qwiic cable, see picture below of the full correctly set up instrument
- qwiic switch or IMU inserted in the wrong direction: the qwiic switch and the IMU should be inserted as shown in the picture below; if they are inserted in the wrong direction, pick them up, rotate them, and insert them again; note the side on which the IMU markings are, the sides IN and OUT of the qwiic switch, and the position of the qwiic cable
- broken / not well soldered magnetic switch leg: the magnetic switch legs should be well soldered on both ends; if one of them is not well solder, fix this by re-soldering the corresponding leg with a soldering iron



If you encounter issues that you cannot solve / other than these, please open an issue here and I will try to help you.
