jerabaul29/OpenMetBuoy-v2021a/(threads)

Thread 3 (2021-12-09):

wrap volatile IRC-modified variable access and reads in critical section

jerabaul29, 2021-12-09:
Wrap in critical section to avoid concurrency issues.

jerabaul29, 2021-12-09:
(do it with interrupts / noInterrupts arduino commands).

jerabaul29, 2021-12-10:
Fixed.

Closed 2021-12-10.

Thread 4 (2021-12-10):

use RTC instead of 1s interrupt + volatile memory

jerabaul29, 2021-12-10:
For now I am setting the RTC to generate interrupts at 1s intervals, and counting with an IRC the number of seconds. As pointed by @gauteh , I could probably just do everything directly with the RTC, without using an additional IRC. That may require some more HAL calls / setup.

gauteh, 2021-12-10:
* https://github.com/sparkfun/AmbiqSuiteSDK/blob/e280cbde3e366509da6768ab95471782a05d2371/boards/apollo3_evb/examples/rtc_print/src/rtc_print.c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
* https://github.com/sparkfun/AmbiqSuiteSDK/blob/e280cbde3e366509da6768ab95471782a05d2371/boards/apollo3_evb/examples/rtc_print/src/rtc_print.c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

You don't need all the TIMER stuff from that example.

jerabaul29, 2021-12-10:
Thanks :) . Agree that looks better, but also a bit worried that there are many moving parts, a bit afraid that I can easily shoot myself in the foot if I set a non self consistent bunch of options at the same time.

Thread 7 (2022-02-13):

peripheral manager wrapper class

jerabaul29, 2022-02-13:
Have a "peripheral manager" to help manage peripherals such as I2C and SPI that may be shared between several chips. The idea is to make it easy to keep track of when to switch on / off the peripherals when needed or not, in particular to save power.

I think it may be a simple wrapper class, something like:

```
size_t max_nbr_users = 8;
using userid = char[3];

template<typename T>
PeriphepheralManager{
  public:
    begin(userid)
    end(userid)
    peripheral
    force_end
    active_users
  private:
    etc::vector<char[3], max_nbr_users> active_users
}
```

jerabaul29, 2022-02-13:
implementation ongoing

Thread 8 (2022-02-13):

peripherals manager

jerabaul29, 2022-02-13:
@gauteh I am building now something I felt I mess in the previous version of the buoy - a way to keep track of whether a peripheral is in use or not, to talk to which devices, and how this knowledge should be used to swith the peripheral on / off.

This is what I am implementing here:

https://github.com/jerabaul29/OpenMetBuoy-v2021a/blob/feat/platformio-tracker-add-peripheral-manager/tracker/lib/peripheral_manager/peripheral_manager.h

https://github.com/jerabaul29/OpenMetBuoy-v2021a/blob/feat/platformio-tracker-add-peripheral-manager/tracker/lib/peripheral_manager/peripheral_manager.cpp

If you have any comments / criticisms / thoughts etc, as usual will be happy to hear, but as usual no problem if you are too busy to look at it :) .

gauteh, 2022-02-14:
This is a bit similar to a bus manager, or [`shared_bus`](https://docs.rs/shared-bus/latest/shared_bus/macro.new_cortexm.html) in rust (but without the power management of the device). You probably have to assume that the PeripheralManager or BusManage(?) will be used from multiple threads, so it needs to use a cortex-m mutex (essentially using interrupt_free context), see the shared-bus source code.

One way to do this is to wrap the I2C device in the BusManager, then you can hand out new leases to it to each device and the bus manager will synchronize their access. Both sharing the I2C bus and doing power-management at the same time might complicate the design, maybe it should be two split in two concepts?

jerabaul29, 2022-02-14:
Many thanks for the comments :) . I think I will work with the hypothesis that it is single threaded so far :) . When not using a RTOS the code is single threaded except for the interrupts, and this is not some operations that should be done from within an interrupt. What do you think?

gauteh, 2022-02-14:
Yeah. Just reading from the same I2C bus in an interrupt - say sampling the IMU from RTC or new-sample-interrupt will be unsafe unless you sync the bus access.

jerabaul29, 2022-02-14:
Right, I had not thought about that, thanks. I will think a bit extra about it. My idea originally was to use this manager to only keep track of switching things on and off, but I see what you mean. Thanks! :)

jerabaul29, 2022-02-14:
This is really interesting - I am so used to the arduino way of thinking, where we do "everything" in a single thread, and interrupts are not used for "hidden multithreading", that I forget that such things can happen ^^ :) .

I have one worry, and it is that, given that I use arduino libraries that are often quite "low quality" / not thought for ISR driven mutlithreading, if I start doing things more complex than updating a counter from an ISR (like, if I communicate with a device on I2C / SPI from within an interrupt), things will likely break (like, getting stuck in an ISR, because it relies on some delay that is implemented using an ISR, or something like this). So I think I will avoid doing stuff like reading a device from an ISR, and instead have my own hand-engineered "event loop" of some kind. This is a poor man's fix, but I think I am stuck there as long as I remain in the arduino ecosystem - and I think alternatives are not fully mature yet, and anyways I do things that go quite slow, so arduino ecosystem is good enough to me so far :) . But many thanks, will keep it in head.

I will update the documentation to make this clear :) .

jerabaul29, 2022-02-15:
Actually, the library for the 6dof for example looks very good; I think I will implement what you suggest here, as there should be no issues using the library from withing an ISR triggered context.

So what I plan would be to implement things so that:

- to use the port, you have to "loan it",
- the port "loaning" is protected by i) disabling interrupts, ii) a mutex; this way, cannot be used by 2 separate threads, and cannot jump in an interrupt / "hidden thread" either, as this would block things up - i.e. avoid no more progress in the first thread that is holding the mutex, and no progress in the ISR that is trying to get the mutex.

I have to think if I create 2 methods (loan and give_back), or if I build an additional object to do RAII.

Anything I am missing @gauteh ? :) (and thank you again for your patience and explanations :) ).

gauteh, 2022-02-15:
If you are the sole owner (own with mutability in rust) you don't need to protect it with the mutex (that is you have no other devices on the same I2C bus, and can pass it to the ISR). Otherwise Mutex (implemented using interrupt guards) works!

Thread 10 (2022-02-22):

instrument corresponding to the paper

jerabaul29, 2022-02-22:
TODOs:

- list of components
- assembly lists
- code
- versions of the code with pre compiled and a bit of explanations
- assembly instructions
- how to get started programming the board
- discuss here through issues

Closed 2022-02-28.

Thread 15 (2022-02-25):

add "end user manual"

jerabaul29, 2022-02-25:
add end user manual:

- make sure rock7 activated and credits
- turn on and off
- different working modes
- color of the leds
- report issue and debugging

Closed 2022-03-03.

Thread 16 (2022-03-01):

add snap rivets, plastic plate

jerabaul29, 2022-03-01:

Closed 2022-03-01.

Thread 22 (2022-03-09):

wave sensor (9dof): where to position it and how to fix breadboard?

CatherineTaelman, 2022-03-09:
Should the wave sensor (9dof) be placed right next to the antenna or rather on the opposite side of the box?
And how is the breadboard attached on the wall of the box? (glue? duct tape?) It is not visible on the pictures in the manual. Thank you!

jerabaul29, 2022-03-09:
Location and orientation of the 9dof should not play a role. I have it on the same side of the batteries as the antenna, but a bit apart from each other. Anyways, GPS/Iridium is never active at the same time as the 9dof as things are now, so it should not play a role. I personally wrap it in duct tape (no naked metal), tape it to the wall, and add a dot of glue after testing :) .

Does that sound reasonable? :)

CatherineTaelman, 2022-03-09:
Sounds good, we will also have the antenna and wave sensor on the same side. There is enough space for that in the big boxes

jerabaul29, 2022-03-10:
Updated the instructions.

Closed 2022-03-10.

Thread 25 (2022-03-09):

STEVAL-MKI207V1 instructions for connections

CatherineTaelman, 2022-03-09:
A question about the intructions found here: https://github.com/jerabaul29/OpenMetBuoy-v2021a/blob/main/instrument_hardware/ST_eval_instructions.md .

**Is it correct that we should be connecting the red qwiic cable (3.3V) to pin 4 for SCX and pin 5 for SDX?**

Reason for confusion is the following:
From the diagram found online (https://www.st.com/en/evaluation-tools/steval-mki207v1.html), it seems like SCX is connected to two pins (P4 and P24), but the connection to P24 had a resistor that says DNM, which we assume means 'do not mount'. So we concluded that the red cable should go to P4 for SCX. Same holds for SDX (with P5 and P17 as connected pins), where P17 had a DNM resistor, so the red cable for SDX should go to P5.

Might be nice for future users to add the schematic diagram of STEVAL-MKI207V1 as a link on 'ST_eval_instructions.md' page :)

jerabaul29, 2022-03-09:
Great to see you go in such details to check :) . Many thanks for raising this issue here :) .

TLDR: yes, I think you are right, and thanks for pointing this out :) .

cc:ing @gauteh here :) (Gaute should get credits for finding that the chip was available in this way, and helping me find out how to correctly wire it :) ).

A side note: @gauteh had looked in details at the datasheet for the ISM330DHCX itself for knowing which pins to connect or not, see the datasheet available at: https://www.st.com/en/mems-and-sensors/ism330dhcx.html section 3.1:)

Regarding your question: I *think* (I do not have the chip under the hand to double check; if you and / or @gauteh can confirm it would be perfect :) ) that you are right and that the pins to use are the pins connected to R3 and R5, ie pins P4 and P5, ie the SCx and SDx on the side of VDD and VDDIO rather than on the other side. I agree that it looks like the pins SCx and SDx on the other side of the breakout, i.e. pins P17 and P24, are only "connected" through a non-mounted resistor, ie not connected and not active. This is indeed very confusing, and I will have to update the instructions, to make it clear that the pins on the side of VDD and VDDIO should be used, and NOT the pins on the other side, when connecting SCx and SDx.

I was actually not really aware of this, went a bit fast and was a bit sloppy myself, and I just connected to some "randomly chosen" SCx and SDx on my breakouts... It turns out that, since I am "luckily lazy", I connected the SCx and SDx corresponding to pins P4 and P4 to +3.3V, since these are the 2 close to VDD and VDDIO, so I could cut a shorter jumper ^^ . This is actually (barely) visible on the picture https://github.com/jerabaul29/OpenMetBuoy-v2021a/blob/main/instrument_hardware/jpg/STEval_PCB.jpg . If you zoom there you can see that I did let the SCx and SDx on the SDA/SCL side unconnected, and I connected instead the SCx and SDx on the VDD and VDDIO side. Pure luck, but need some now and then ^^ :) .

As a side note:

- I tested relatively extensively my setup corresponding to the description above, and it seems to work very well
- I had initially not read the datasheet as I should have, and not connected SCx and SDx at all, and things were working fine if I remember well (though as @gauteh had pointed out then, floating inputs that should be clamped was not a good idea)

Having an extra pair of eyes on this would be great :) . So if you can read this being quite critical / not "trusting", and double check and confirm, would be great :) .

Let us confirm, keep the issue open, and I will update the readme :) .

jerabaul29, 2022-03-09:
@gauteh  I thought so, that it does not matter which SCx and which SDx was connected as long as one of each was connected to 3.3V, but looks like as @CatherineTaelman points out from the STeval datasheet and how the PCB looks like that the SCx and SDx on the side of the SCL / SDA pins are just not connected to the chip in the center at all - while the SCx and SDx on the side of VDD and VDDIO do are connected to the chip in the center.

jerabaul29, 2022-03-09:
Would need a breakout under my hand (all mines are mounted in the boxes that are now sealed and glued) and a multimeter to check, though :) .

CatherineTaelman, 2022-03-09:
Thanks for double-checking and confirming! We also noticed indeed that the SCx and SDx on the side of the SCL / SDA pins are not connected at all to the chip. So we are going for the connections to P4 and P5 :)

jerabaul29, 2022-03-09:
Perfect, then this is confirmed, and I will update the md instructions file and let you know :) .

gauteh, 2022-03-09:
Great, that is a very important bit of information. Good catch!

jerabaul29, 2022-03-09:
Many thanks again, updated the readme here: https://github.com/jerabaul29/OpenMetBuoy-v2021a/commit/c627122b078af8c59dee82092ee670f9348295b6 .

Btw @gauteh , is it ok if I add your schematic (see under) to the md file (with credits of course :) ):

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

gauteh, 2022-03-09:
Of course 😊

ons. 9. mar. 2022, 15:59 skrev JR ***@***.***>:

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

CatherineTaelman, 2022-03-09:
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

That schematic is really nice for the readme! :)

tnn77, 2022-04-24:
Dear @jerabaul29
Sorry, I have really lagging on this, and now I need to move fast for the AWI prep.

May I ask about the resistor R1? So have you guys had a bit more experience now with this chip and the resistor R1 is not necessary?

Thread 27 (2022-03-10):

firmware versions - brainstorming

jerabaul29, 2022-03-10:
@CatherineTaelman let me know if you want more versions of the firmware with specific parameters :) .

To summarize:

- upload of wave firmware on gps instrument is wasteful but will work
- upload of gps firmware on wave instrument will not work - the instrument will reboot in loop, looking for the 9dof
- make sure to upload correct wave firmware: the "standard" wave firmware on steval wave instruments will reboot in loop, looking for the non existent magnetometer
- doing some test under the open sky is the best way to control that everything is fine :)

jerabaul29, 2022-03-11:
Sounds good :) . What you can do too is take it to the open sky (outside or out of the window) "just a few minutes" to get a GPS fix, so that the processing continues and goes forward, this way you can check that the acceleration data are well sampled by looking at the serial output :) .

jerabaul29, 2022-03-11:
Btw, added a readme here: https://github.com/jerabaul29/OpenMetBuoy-v2021a/tree/main/legacy_firmware/binaries . If you have any comments fee free :) .

Closed 2022-03-31.

Thread 28 (2022-03-10):

cheaper bundles from Rock7 when buying more?

jerabaul29, 2022-03-10:
@CatherineTaelman if you do get a cheaper bundle when buying more from Rock7 please let me know (how much do you need to buy / how much cheaper :) ).

jerabaul29, 2022-03-11:
FYI @jvoermans @tnn77 : may allow to reduce the costs a bit if buying for many instruments at once :) .

tnn77, 2022-03-15:
@jerabaul29
which cost are we talking about here??? Iridium fee or the Rock7 Iridium module?

jerabaul29, 2022-03-16:
The cost of iridium credits bought from Rock 7. Ie the credits bundles. Seems it may be possible to buy even more at once to get a better price, by taking contact directly with Rock 7 sales department, but this is only a hypothesis.

tnn77, 2022-03-16:
Great. Thank you so much for the info. We will try that for next time.

jerabaul29, 2022-03-31:
Just to double check @[CatherineTaelman](https://github.com/CatherineTaelman) , did you try to negociate a cheaper bundle, or just bought it "as is" for this time? :)

CatherineTaelman, 2022-03-31:
I havent asked, we decided to go for the 20 000 credits bundle for now, as a start. But the company is very responsive to emails, so it is easy to get in contact with them for any requests:)

jerabaul29, 2022-03-31:
Ok. Would need to compute the cost :) . Is it easy to switch offering?

jvoermans, 2022-03-31:
I think it isn't much of a problem to switch, but the data plans are for 12 months, so doesn't work for me. I'm asking now for larger bundles...

jerabaul29, 2022-03-31:
Aaah, ok, yes 12 months binding is not so good. Bigger data plans would be better :) .

jerabaul29, 2022-04-05:
Many thanks @jvoermans for looking into this. So it looks like no real interest in it, no real cost cuts to get. Closing.

tnn77, 2022-05-26:
@jerabaul29 @jvoermans
FYI - it was quite easy to set up NET30 terms between Ground Control and AWI. This allows you to buy line rental and credits without paying upfront, and every 30 days they will do a sweep, collate all spends on the account and send through an invoice.

Something to consider for large scale deployments.

I think all you need to provide them is the approximate number of line rentals and credits you'd expect to purchase.

Closed 2022-04-05.

Thread 30 (2022-03-21):

cutting out LEDs

CatherineTaelman, 2022-03-21:
You indicate to cut out the 'power LED' to save the batteries. Does it make sense to also cut out the other LEDs? Or are they rather useful to check that the instrument is working properly and don't consume so much power anyway?

jerabaul29, 2022-03-21:
(but cut the LEDs on the qwiic switch, these are some always on that use quite a bit :) ).

jerabaul29, 2022-03-31:
Updated the doc, closing.

Closed 2022-03-31.

Thread 31 (2022-03-24):

request for specific binary files of firmware

CatherineTaelman, 2022-03-24:
Hi Jean,

We will be deploying 3 drifters on icebergs. These drifters have only GPS (no wave sensor).
We would like to have two different sampling and transmission rates because of two different scenarios:

- One drifter will be deployed on a floating iceberg. For this one, we would like the GPS location to be sampled every 30 mins and transmission approx. every 3 hours.

- 2 drifters will be deployed on grounded icebergs. For them, it is crucial that we extend the battery lifetime as much as possible (we'd like to still have them working after 2 months). We were thinking of: sampling GPS location every 12 or 24 hours and transmitting every 48 hours. Does that sounds reasonable to you?

The question is: could you compile 2 different binary files with these specific sampling and transmission rates?

Thank you so much already!

jerabaul29, 2022-03-24:
That sounds reasonable :) .

The compiled binaries are available in the repo now.

I have never used GPS sampling rate less often than 1 hour before now. This should not cause any issue that I know of, but may be a good idea to test a bit thoroughly the drifters with 12hr resolution and 48hr latency :) .

jerabaul29, 2022-03-24:
PS: how are things going, have you been able to test that all works well? :) .

CatherineTaelman, 2022-03-25:
Hi and thank you so much for providing the new binary files! We are right now doing the final assembly of all the drifters. There are some struggles with getting the Iridium package through the university finance system, so that has delayed the testing fase. But I will be putting out 3 drifters this evening to start testing over the weekend. I will let you know on Monday if everything works well:)

CatherineTaelman, 2022-03-25:
small other question: what is the transmission rate in 'steval_gps_waves_drifter.bin'? That is the one we will use for the 17 drifters in large boxes.

CatherineTaelman, 2022-03-25:
From the logging file I read out in Arduino IDE,  I assume the transmission rate is every 2 hours (after initial GNSS fix fail, it goes to sleep for 7200 seconds).

When checking the other variables in 'steval_gps_waves_drifter.bin', I noticed the variable 'interval_between_wave_spectra_measurements: 7200'. So that means it measures wave spectra every 2h, right? In the description of the binary files it says every 3h, just want to check what is the correct value :)

jerabaul29, 2022-03-25:
Sorry, away from my computer.

The 'true' answer is, as you say, the serial output :) . The 7200s after failed GPS fix is not the frequency of GPS measurements, but a way to save battery if not GPS reception, for example if switched on while in a container by mistake.

If I remember well, the GPS measurements frequency should be 30 minutes, and transmission every 2 hours. That should be visible in the serial output.

If you are in doubt, just copy paste here the start of the serial output, and I can go through it for you here :) .

CatherineTaelman, 2022-03-25:
Check, GPS every 30 mins and transmission every 2h is indeed what the serial output says :) Thanks for double-checking!

CatherineTaelman, 2022-03-25:
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

jerabaul29, 2022-03-25:
This will actually be around every 3 hours, since 6 messages minimum per GPS packet :) .

CatherineTaelman, 2022-03-25:
Okay I see, thank you!

jerabaul29, 2022-03-31:
Seems to be confirmed to work well, closing :) .

Closed 2022-03-31.

Thread 33 (2022-03-31):

smart "freeze in" vertical mount

jerabaul29, 2022-03-31:
@[CatherineTaelman](https://github.com/CatherineTaelman) if you are ok to send a picture of your smart "freeze in" vertical mount that would be great :) . I think that the idea could be used by both @jvoermans and @tnn77 to avoid problems with being snowed in.

tnn77, 2022-04-05:
Hi, @jerabaul29 .
I'm very curious about this. If not a picture, is it possible to share a sketch of this mount?

jerabaul29, 2022-04-06:
Just putting a small hand drawing, from what I understood from @CatherineTaelman , all credits going to her :) (hope it is ok that I upload here a sketch of what you were suggesting? if not, let me know and I will remove it at once).

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

CatherineTaelman, 2022-04-06:
the long bolts going through the PVC pipe and connecting the two metal hooks to the pipe, the 2 small bolts are meant to attach the drifter box to the metal hooks

jerabaul29, 2022-04-06:
Many thanks for the extra pictures, looks really good :) .

When setting these up, I think that a tradeoff question is "how high above the ice" should the box be: the higher above the ice, the less risk for getting buried down by snow (which is really great for iridium communications), but the higher the risk to i) be spotted by bears, ii) start vibrate if there is a lot of wind / the tube is not very stable. Wonder where the optimal value of this tradeoff goes: 5cm above the ice? 10? 15? 20? even more (I think 20cm is a maximum though)?

tnn77, 2022-04-06:
Dear @CatherineTaelman @jerabaul29
thank you so much. this is a nice idea.

I have a similar question as well. I was wondering how much elevation we may gain with this approach. I guess the target height would depend a lot on the expected measurement duration and snow conditions.

jerabaul29, 2022-04-22:
Closing now, will add in a dedicated readme file, feel free to re open if necessary / if you want to discuss further :) .

Closed 2022-04-22.

Thread 35 (2022-04-04):

A version without the Qwiic Power Switch

gauteh, 2022-04-04:
The [Qwiic Power Switch](https://www.sparkfun.com/products/16740) is out of stock with no dates for estimated availability. Would it be possible to have a version where it is not necessary, e.g. using compile flags?

Best Regards, Gaute

jerabaul29, 2022-04-04:
That may be possible, but with a large power consumption penalty. Have you tried to send a message to Sparkfun asking about availability? For now, I can provide you with a few from my "personal" stock :) .

gauteh, 2022-04-04:
The IMU uses about 1.5mA, so that should translate to at most twice the present consumption - probably much less.

jerabaul29, 2022-04-04:
Just got confirmation from SF (I tagged you there :) ) that it is in the production queue :) . In the meantime you can get a few from me, and give me some back when you get to order from SF :) . These are so cheap that it may be worth ordering a 10 or 20 at once to have a bit in stock :) .

gauteh, 2022-04-04:
Great! If I can borrow some from you I am happy!

jerabaul29, 2022-04-05:
The conclusion is that, for now, I will not develop one: closing.

Closed 2022-04-05.

Thread 37 (2022-04-07):

previous version of the binary steval_gps_waves_drifter.bin was not always switching off the imu

jerabaul29, 2022-04-07:
@[CatherineTaelman](https://github.com/CatherineTaelman)  @jvoermans and @tnn77  , the previous version of https://github.com/jerabaul29/OpenMetBuoy-v2021a/blob/main/legacy_firmware/binaries/steval_gps_waves_drifter.bin was not always switching off the IMU after use. This did not result in any issue with the functioning of the instrument itself, but will increase power consumption. The firmware version I just pushed fixes this issue, and should both work well (as the previous one), and reduce power consumption by making sure the IMU gets switched off.

- I will fully test now and let you know / confirm that it works well
- I recommend that you update the firmware of the instruments that are not sealed and were using the old steval_gps_waves_drifter.bin firmware , if possible. If not possible to update, this is not a really critical issue, as the power consumption increase was not too bad, but still, better to be power effective and get longer battery life :) .

jerabaul29, 2022-04-07:
Confirm the updated firmware works perfectly well :) .

jerabaul29, 2022-04-22:
Closing for now, feel free to discuss further if anything is unclear :) .

jerabaul29, 2022-04-22:
@CatherineTaelman not sure if you received the notification, just doubling on it just in case :) .

CatherineTaelman, 2022-04-22:
Hi Jean, thanks for noticing me about this issue, it has slipped through my attention with all the other Github discussions recently.. I will download the updated binary file and upload it on the drifters here on the ship:)

jerabaul29, 2022-04-22:
Sounds good :) . My advice: download it and test it on one instrument first (you never know ^^ ), anyways you have good time until you reach the ice I guess? :)

CatherineTaelman, 2022-04-22:
okay, I will try it out on one instrument tonight (if time allows), we are leaving harbour any moment now and will reach the ice in 1-2 days approx. So should leave a little bit of time to test the functionality with the new code :)

Closed 2022-04-22.

Thread 39 (2022-04-23):

note about using as a floating buoy without the PVC tube buoy under

jerabaul29, 2022-04-23:

jerabaul29, 2022-04-24:
"that behaviour should be like iSphere: surface current + 3% of wind (otherwise current + 1% of wind)"

jerabaul29, 2022-04-24:
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

jerabaul29, 2022-04-24:
Make **very** watertight: fill screw holes with silicon (both over and under), put silicon on water tight sealing in addition, put a layer of duct tape over the silicon on top of the sealing - since will be heavily exposed to seawater over time.

Closed 2022-04-26.

Thread 45 (2022-04-29):

notes about end user manual: similar to what we discussed with Gaute about antenna, iridium vs gps, reboots

jerabaul29, 2022-04-29:

Closed 2023-05-12.

Thread 48 (2022-05-02):

The Hammond box is a bit tight for upright antenna

gauteh, 2022-05-02:
The suggested hammond box is a bit tight to get the antenna oriented upright: https://www.elfadistrelec.no/en/watertight-enclosure-smoked-lid-polycarbonate-120x120x80mm-clear-light-grey-hammond-1554p2gycl/p/30100709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

gauteh, 2022-05-02:
@benoitLD

jerabaul29, 2022-05-02:
Yes, the RND box is a bit better. But note that it is not critical that the antenna is pointing completely upwards; 50 degrees upwards is fine enough :) .

jerabaul29, 2022-05-02:
I will update the documentation

gauteh, 2022-05-02:
:+1: probably worth keeping it 90deg in the first place, if it can be easily fixed with a higher box. a bit more margin.

Closed 2022-05-03.

Thread 49 (2022-05-02):

warn about low quality battery holders; prefer batteries with soldering "tails"

jerabaul29, 2022-05-02:

jerabaul29, 2022-05-02:
- both in components list and assembly instructions
- check good contact with and without batteries
- best is to buy batteries with the soldering legs directly

Closed 2022-05-03.

Thread 50 (2022-05-05):

cheaper batteries

jerabaul29, 2022-05-05:
Would be possible to test cheaper batteries, from EVE or Fanso, which should have the same overall specs:

https://eu.nkon.nl/disposable-batteries/lithium/c-d-9v-size/fanso-er34615m-d-formaat-lithium-batterij-3-6v.html

https://eu.nkon.nl/disposable-batteries/lithium/c-d-9v-size/eve-er34615-d-formaat-lithium-batterij-3-6v.html

jerabaul29, 2022-05-05:
(may request adding a supercap in parallel of the batteries to power the iridium modem)

jerabaul29, 2022-05-06:
FYI @TryggviLab . Would request a bit of tests though. I think the Fanso battery could be a drop in replacement. The Eve battery has a max continuous current that is too low, but may be ok with a supercap or two to help take away peaks of current draw.

Tadiran SL 2780 with supercaps in parallel may also be a possibility, and I think NKON has them in stock with soldering "tabs".

The scary thing is that at low temperatures (-30 or -40), some of these have a lot of voltage drop. So the safest remains the LSH20.

Thread 51 (2022-05-10):

About DS18B20

jerabaul29, 2022-05-10:
Need to:

- re-test
- document

jerabaul29, 2022-05-10:
@TryggviLab I would need to spend a bit of time to clean up / document things around temperature measurements, but basically I have been using successfully some DS18B20 temperature sensors, up to 8, put on a "temperature sensor measurement string". Using waterproof ones, they can be deployed out of the enclosure, to measure temperature at different depths in the snow or water (for example, these work great: https://www.sparkfun.com/products/11050 ), which is quite valuable for us scientists :) . So definitely, adding some "easy to use" PCB traces would be great.

To attach them, I have used:

- powered mode (ie 3 wires rather than 2 wires parasitic mode)
- D4: 3.3V supply by digital pin, protected by typically 50 ohms to avoid shorting in case of a broken temperature sensor
- D35: signal, shared by all temperature sensors, protected by typically 50 ohm (same, to avoid shorting)
- GND
- pullup D35 to D4, using typically 4.7kOhm with 6 thermistors

So the circuit looks like the attached picture.

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

Typically, providing the traces on the carrier PCB, with the possibility to connect up to 8 temperature sensors (ie array of 8 GND, 8 PWR, 8 DAT, grouped "3 by 3 close to each others" so that the wiring / soldering is easy), but without the resistors (providing through holes spaces that the users can fill with the right value) would be amazing :) .

Thread 52 (2022-05-10):

Alternatives to core component (Artemis Global Tracker)?

AndresSepulveda, 2022-05-10:
Hi,

 Seems the SparkFun Artemis Global Tracker is out of stock. Do you have alternatives to this component?

https://www.sparkfun.com/products/18712

I wonder if it is being dicontinued or it is just a temporal glitch.

 Regards,

  Andres

jerabaul29, 2022-05-10:
(but my 2 cents @AndresSepulveda : if you plan a large deployment, try to start with the procurement of the parts at least 6 months in advance if possible, as things are a bit chaotic with the ongoing chips shortage; I think that contacting SF well in time, they will usually be able to set up a custom run if necessary - at least this is what I experienced :) ).

jerabaul29, 2022-05-10:
That sounds excellent :) . And of course, if you have any more questions, open an issue here on the repo :) . If you want we can also have a Zoom chat some day - maybe for example after you have had a look at the repo contents, so that we can discuss any question / uncertainty you may have, future developments, etc? :) ).

Btw, depending on your timing, @TryggviLab at Labmaker is working (still WIP, you should check with him, and I think they at Labmaker are currently still building / evaluating a prototype to decide if they want to go full scale with the production) on either / both i) providing a "master PCB" that can be used to mount all components to make assembly easier, ii) producing commercially the open source design. So that may be an alternative way to procurement. I will anyways update the Readme when there is anything "firm" on this side :) .

AndresSepulveda, 2022-05-10:
Great, thanks. Let me clear a few other deadlines and I will contact you for a Zoom chat.

jerabaul29, 2022-05-31:
A few are back in stock @AndresSepulveda , 4 as of just now, crossing fingers for more soon :) https://www.sparkfun.com/products/18712 .

jerabaul29, 2022-05-31:
Already sold out again...

brhoff720, 2022-05-31:
Hi JR and all,

We're working to get more available.  We moved these from SparkX to SparkFun to try to ensure a constant stock level.  However, global supply chain challenges have hindered our efforts.  This is on our radar to get back in stock.

jerabaul29, 2022-06-09:
Thanks @brhoff720 for the confirmation that you are trying to re-establish some stocks :) .

@AndresSepulveda in the meantime, looks like while SF is sold out, Mouser does have a couple in stock: https://no.mouser.com/ProductDetail/SparkFun/WRL-18712?qs=Rp5uXu7WBW%2FvtVY5LVjy9A%3D%3D .

jerabaul29, 2022-08-19:
28 AGTs at SF website now, crossing fingers they keep producing do that stocks hold :) . Btw @AndresSepulveda have you been able to build / test the OMB? :) Let me know if there is anything I can do to help :) .

jerabaul29, 2022-08-19:
(we have deployed nearly 80 in the last 5 months with great success, so the design is definitely good :) ).

brhoff720, 2022-08-19:
I thought I pinged this thread as they came back in stock.  And yes, we are trying to keep this in stock more consistently.  If you are needing more than you see available, ping me and I will see what can be done to push to front of production queue.

AndresSepulveda, 2022-08-19:
Not yet, dealing with other issues now, but I do keep it in mind.
-------- Mensaje original --------De: JR ***@***.***> Fecha: 19/8/2022  16:28  (GMT-04:00) A: jerabaul29/OpenMetBuoy-v2021a ***@***.***> CC: Andres Sepulveda ***@***.***>, Mention ***@***.***> Asunto: Re: [jerabaul29/OpenMetBuoy-v2021a] Alternatives to core component (Artemis Global Tracker)? (Issue #52)
28 AGTs at SF website now, crossing fingers they keep producing do that stocks hold :) . Btw @AndresSepulveda have you been able to build / test the OMB? :) Let me know if there is anything I can do to help :) .

—Reply to this email directly, view it on GitHub, or unsubscribe.You are receiving this because you were mentioned.Message ID: ***@***.***>

Closed 2022-08-19.

Thread 63 (2022-08-31):

GND on qwiic switch: is it exactly the same on both sides?

jerabaul29, 2022-08-31:
I think so, but to check with how the PCB of Tak goes.

jerabaul29, 2022-09-20:
seems that yes from the power tests.

Closed 2022-09-20.

Thread 64 (2022-08-31):

antenna cable, impedance, and L-shaped connector

jerabaul29, 2022-08-31:
Can the SMA cable cause loss of signal due to unmatched ampedance? The feelings from Tak seems to say that yes.

jerabaul29, 2022-11-22:
ie this should be quite a bit better than SMA cable: https://no.rs-online.com/web/p/coaxial-adapters/7009600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 .

jerabaul29, 2022-11-22:
L-shaped 90 degrees, SMA male to SMA female, typically 50 Ohm impedance.

jerabaul29, 2022-11-22:
this can be used to hold the antenna, either directly looking up if possible, or else with a bit of an angle

jerabaul29, 2022-11-22:
That looks like a less expensive alternative: https://no.farnell.com/amphenol/sma5072a2-3gt50g-50/adaptor-sma-plug-sma-jack-50ohm/dp/1111341

jerabaul29, 2022-11-22:
@gauteh may be relevant to use some too :) .

gauteh, 2022-11-22:
Thanks. In general it seems to work pretty well as it is also.

tir. 22. nov. 2022, 16:37 skrev JR ***@***.***>:

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

jerabaul29, 2022-11-22:
Yes, but according to Tak et co it was making a big difference (erratic GPS fix vs perfect GPS fix, no iridium vs reliable iridium) when they were testing in Tokyo with bad sky visibility; that may apply to storm conditions / large waves with lots of sea spray in the air / icing on the box as well - if there are a few dBs of RF gain to take for free, why not? :) ^^

Thread 69 (2022-11-07):

alternative magnetic switch

jerabaul29, 2022-11-07:
Following the recommendation from @jvoermans , added the alternative for a more robust magnetic switch in the possible list of components, see:

- 1 x MK15-B-2-OE magnetic switch, normall close: 7 USD: https://www.digikey.com.au/en/products/detail/standex-meder-electronics/MK15-B-2-OE/2765323 , see datasheet at https://standexelectronics.com/viewer/pdfjs/web/viewer.php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

@tnn77 , that may be a good alternative for you, in particular for planning for it if you want to have your own PCB :) .

jerabaul29, 2022-11-07:
Closing, as this was just to notify you, but of course if there is anything you want to discuss feel free to re open and discuss here :) .

tnn77, 2022-11-11:
@jerabaul29
this is very nice. indeed, robust switch would be useful (we usually break a few during production). thanks!

Closed 2022-11-07.

Thread 71 (2023-01-04):

data displaying using OceanDataLab Syntool

jerabaul29, 2023-01-04:
@gauteh @oceandatalab feel free to edit if anything in the "statements" is inaccurate, and / or further discuss what you think is best for the discussion part :) .

---

If I understand well, the current workflow is:

- sfy-data collects data from Rock7 and hosts / organize them in a database and server, accessible through a web API for further use of the data: https://github.com/gauteh/sfy/tree/main/sfy-data (note: may move to a separate repo at some point). An instance of it is now run at MetNo by @gauteh, but could be run by any user locally.

- sfy-dashboard provides a simple visualization of the data, that uses the data from sfy-data; sfy-dashboard is available at: https://github.com/gauteh/sfy/tree/main/sfy-dashboard . An instance is now run at MetNo by @gauteh , showing the data from the MetNo sfy-data server, but could be run by any user locally against their own sfy-data server.

- syntool provides a more advanced visualization of the data, that uses the data from a sfy-data server(s) and renders them in OceanDataLab Syntool. It is now run at OceanDataLab by @oceandatalab , visible for a small set of buoys at: https://ovl.oceandatalab.com/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 .

A possible question is, how to make this further available to more users if they want, can this be automated, and / or can we provide a standard workflow that users can follow to see their data displayed online somewhere?

I guess the steps would be:

- get a sfy-data server to collect and further serve their data; @gauteh , how would you like this to be organized? Do you think it may be possible to offer 2 solutions to users, ie either i) for MetNo to get the users Rock7 details and IDs to track and the MetNo server then collects the users data, or ii) making a simple recipe for helping users run their own sfy-data (a script or container or similar that non expert users could just run?)? I think i) may be easier on users, so if possible that would be great :) . Note: i) may request at some point having data access granularity and different user accounts with access to different subset of the data?

- once a sfy-data server collects the user data, Syntool can be used to display them. Same point here, @oceandatalab do you think it would be possible / how to provide this as a service to the users? If it would be possible for users to provide for example the sfy-data server url and access credentials, and the list of IDs, could you add their data to your tool? And / or a simple recipe for running things locally, ideally a single script or container to run. Note: to keep things organized, it may be useful to be able to search for buoys using both i) category "openmetbuoy", ii) username or sfy-data server url / ID, iii) buoy individual name, iv) a combination of these, as if several users start using this for different campaigns, things may get a bit complicated otherwise.

Do you think / how do you think we should proceed further on that? :)

---

Key points from the email, copying here to keep them easy to find:

- resources to learn the tool: https://www.youtube.com/@oceandatalab , https://www.youtube.com/playlist?list=PL_Nrq3gZvmM-rrE64qr7QqzQir23kzol1
- webportal tool: OceanDataLab Syntool is open source https://www.oceandatalab.com/syntool

oceandatalab, 2023-06-22:
Sorry for the very late reply, the beginning of the year has been quite busy...

Here is a simplified diagram showing how software components interacted when we ingested OMB data in Syntool during the January campaign at sea:

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

As you can see it relies on many 3rd party software and on the custom scheduling system that we use for automating our processing tasks, which makes it unsuitable for a local deployment.

Yet, with some effort it should be possible to replace the 3rd party software by less scalable but simpler/more user-friendly implementations, and to remove the ODL-specific parts of the processing scripts to create a Python package that is easy to install:

- The webservice implementation currently supports only MySQL/MariaDB, these SQL servers may be difficult to install / configure for users. My colleague @zaygraveyard has made some experiments to add support for SQLite: it is usually already installed by default in most operating systems, querying the database does not require a service and Python natively supports it, so it would be a good option for an all-in-one package.
- The Nginx webserver could be replaced by the implementation available in the Python standard library (``python -m http.server``).The Python webservice is a WSGI application running with the ``uwsgi`` server, which conveniently embeds a web server to make the apps available with the HTTP protocol. So all the Web software components could be implemented with Python.
- Some work would be required to turn the processing scripts (download + export to GeoJSON + generation of spectra plots + export to database) into Python-only code without dependency on our scheduling system. They may still require the installation of the ``proj`` library to handle the conversion of coordinates, but aside from that I think all the dependencies are only one ``pip install`` away.
- It would probably be necessary to implement one command to start the Web components (server + service) and another command that the user would execute to fetch and process new data. A configuration file would be needed to pass credentials and the list of devices to process.

So it would turn the previous diagram into this:

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

Not saying that we will have time to handle this in the near future, but this is how I would proceed to create a standalone version that users can run on their own computer.

jerabaul29, 2023-07-09:
Many thanks for the explanation! Agree this looks like quite a lot of work, we can keep this in mind and see if there is a growing user group at some point in the future asking for something in this kind come back to this discussion :) .

Thread 75 (2023-02-27):

updates based on current series

jerabaul29, 2023-02-27:
- recommend the 90degrees SMA adapter instead
- add headers male and female to the BOM for people using the PCB

jerabaul29, 2023-02-27:
- move the 90 degrees to recommended

- for the headers: 0.1" ie 2.54mm pitch, see for example:
  - https://www.elfadistrelec.no/en/wr-phd-straight-male-pcb-header-through-hole-rows-40-contacts-54mm-pitch-wuerth-elektronik-61304011121/p/30024557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
  - https://www.elfadistrelec.no/en/801-straight-female-pcb-receptacle-through-hole-rows-32-contacts-54mm-pitch-preci-dip-801-87-032-10-001101/p/14383998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

jerabaul29, 2023-02-27:
- and breadboard as a "tool" to help soldering

Closed 2023-02-28.

Thread 76 (2023-03-06):

write guide for people using the OMB from Labmaker

jerabaul29, 2023-03-06:
- prepare Rock7
- prepare decoder script
- update the firmware if you want (note: on ubuntu 20.04, need older uploader version)
- put batteries in
- seal "real good"
- wait for a few messages, and run the parsing scripts
- if you want, ask us to host your data on our server

jerabaul29, 2023-03-07:
@AndreaGierisch let us list points I should have in a "Labmaker buoy user helpguide" :)

jerabaul29, 2023-03-07:
- current from only 1 source
- static electricity protection
- what firmware to use
- logging debug info over USB

AndreaGierisch, 2023-03-07:
> @AndreaGierisch let us list points I should have in a "Labmaker buoy user helpguide" :)

Sure :-) Here is a short brainstorming of points which I think could be nice to have in a Quick Start Guide or so:

- What is what when I look at the electronics?
- Create an account at Rock7 to a) buy subscription/credits and b) see the received data
- How to download and start Artemis-Uploader
- How to check whether there is (the correct) firmware installed?
- What the firmware can do, and in which cases I need to write my own firmware
- What batteries to buy?
- What magnet to buy - And can I use the OMB also without magnet (I guess so.)
- Do I have the 6-dof or 9-dof sensor (relevant for firmware, I think?)
- How to change frequency of GPS recordings / message transmission?
- Table with expected battery lifetime
- Table with credits per message (and recordings per message) and price of credits
- Dos and Don'ts like:
-  - never two power sources at the same time
-  - slow cool-down from room temperature to outside
-  - use desiccant bags (and recommendations which/how many?)
-  - seal the box with silicon?
-  - How to best hold the electronics plate when taking it out from the box to reach the batteries

I think I found answers to many of these items already, but it would have been easier of course if all was collected in one place ;-)

jerabaul29, 2023-03-08:
- need to be in the dialout group to access usb port

akorosov, 2023-06-21:
Regarding the batteries: Does the the LabMaker version have parallel or serial connection in the baterry holder? We bough OMB from LabMaker and Lithium LH20 baterries with 3.6V. Can we safely insert them?

jerabaul29, 2023-06-21:
@akorosov the LabMaker version have parallel connected battery holders and expects 2 LSH20 in parallel yes :) . You can safely insert them, just be sure to respect polarity of course (should match the markings on both the PCB and the battery holders).

jerabaul29, 2023-06-21:
- always antenna on when RF modules in use

jerabaul29, 2023-06-22:
Let me know how the tests go / if there is anything I can do to help @akorosov :) . Will be happy to have a chat with you and / or some of your colleagues if I can help :) .

jerabaul29, 2023-06-22:
I tried to summarize at https://github.com/jerabaul29/OpenMetBuoy-v2021a/blob/main/end_user_manual/LabMaker_OMB_instructions.md ; if you want more information, either ask for specific additions here, or open pull requests :) .

Closed 2023-08-08.

Thread 80 (2023-03-17):

decoder: sometimes wave message has datetime_fix, sometimes datetime_packet

gauteh, 2023-03-17:
Up until now we have only used datetime_fix, but it seems that there is sometimes datetime_packet. What is the difference?

https://github.com/gauteh/sfy/blob/main/sfy-processing/sfy/cli/collection.py#L113

gauteh, 2023-03-17:
https://github.com/gauteh/sfy/pull/119

jerabaul29, 2023-03-17:
These concepts were maybe not so well defined in my head initially, so this is maybe not so consistent over time / files, and I may unfortunately have been inconsistent, but I would say:

- a fix is actually getting a valid fix from the GPS
- a packet is a fix encoded into its binary string, that becomes a part of a message
- a message is one or several packets, with a tiny bit of metadata, encoded in binary string, that is sent over iridium

Maybe we should think about standardizing the terminology / concepts for future buoy developments? :)

gauteh, 2023-03-17:
So they are synonymous now and we can treat them the same? (I assumed one was the time of packet recording, and the other was the time of gps fix).

jerabaul29, 2023-03-17:
Sorry, you are right, we were discussing different aspects (ie hierarchy in the data vs individual data fields). Honestly, most of this was designed in 18hr sprints in 2021 while I was on the icebreaker, so there is no real "master plan and consistent engineering", sorry about that.

Yes, these are anyways always posix timestamps, associated with the data, either as part of a full GPS fix, as in

https://github.com/jerabaul29/OpenMetBuoy-v2021a/blob/c7c9c8c10c187cacb17ec91363d69f7dd16eff34/legacy_firmware/decoder/decoder.py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

or as part as  a wave packet, which does not really contains a GPS fix per se, but includes the RTC UTC posix timestamp, as in

https://github.com/jerabaul29/OpenMetBuoy-v2021a/blob/c7c9c8c10c187cacb17ec91363d69f7dd16eff34/legacy_firmware/decoder/decoder.py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

I think I was not very consistent when I coded all of this, sorry. If I should find time to recode all of this in a consistent way, I would use the name datetime_fix in the context of an actual GPS fix, while datetime_packet should be used in the context of getting the UTC posix time for for example a wave or thermistor packet, but not from a true GPS fix. At the present time, this is not really consistent, sorry.

jerabaul29, 2023-03-17:
My terminology is very badly chosen and has overlaps / inconsistencies. I think we should also standardize the terminology / concept regarding the name of posix timestamps coming from either a GPS fix or pulling the RTC.

jerabaul29, 2023-03-17:
(doing a ctrl-f on the file, I used datetime_packet only a couple of time when adding posix information from the UTC clock to wave and thermistor packets, though in the dataclass it is still called a datetime_fix ... not very consistent. :( . At the same time, all of this is brittle, I think I will, in the context of the OMB, keep it as is for now, and next time an OMB version gets developed, start from scratch being more consisten :) ).

jerabaul29, 2023-03-17:
Sounds good :) . Closing for now, feel free to re open if needed :) .

Closed 2023-03-17.

Thread 87 (2023-08-08):

Robustify qwiic switch start

jerabaul29, 2023-08-08:
May want to robustify all occurences of

https://github.com/jerabaul29/OpenMetBuoy-v2021a/blob/61c2efe1ac680ce5c10dcf9ee42b557862d795df/legacy_firmware/firmware/steval_gps_waves_drifter/imu_manager.cpp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

into something similar to

https://github.com/jerabaul29/OpenMetBuoy-v2021a/blob/61c2efe1ac680ce5c10dcf9ee42b557862d795df/legacy_firmware/firmware/steval_gps_waves_shortthermistors_drifter/imu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

Note that since we have code duplication and we provide many pre-compiled firmwares, this would request:

- updating all the code duplicates
- re-compiling all the firmware versions

Given that these seem to have been working well for quite some time, it is probably not worth the effort and the risk of introducing mistakes in the process.

Thread 88 (2023-08-08):

Add test bench to check the ID of thermistors

jerabaul29, 2023-08-08:
TODO: add test bench firmware to test ID of thermistors (in order to be able to label them).

jerabaul29, 2023-08-08:
Done, will need to test and add wiring instructions to the readme there.

Closed 2023-08-14.

Thread 89 (2023-10-28):

adding criteria to push to buffer when there is no wave signal (for large number of OMBs on fast ice to cut Iridium cost).

tnn77, 2023-10-28:
@jerabaul29
Hi, Jean.

We are not sure whether we implement this or not, but as discussed, we would like to have this as an option. The idea to have a push criteria was suggested by Tsubasa. For now, we simply use Hs and likely a value around 1 cm. The sensor spec noise is about 0.4 cm, we achieved 0.5 cm in NABOS and 0.8 cm in JARE63 (the Antarctica 2022 deployment). So I think 1 cm may be a good start.

I think the added lines of the code is straight forward, but if you can check/have suggestions, please let me know. Thanks so much.

https://github.com/tnn77/OpenMetBuoy-v2021a/blob/85db725043142f9071fa8df4f77205153f3e6669/legacy_firmware/firmware/jare65/wave_analyzer.cpp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

tnn77, 2023-10-28:
@jerabaul29
thanks for taking a look!
the sensors are on the ship already, but I am doing work there this week, so I will test this out and let you know.

tnn77, 2023-10-31:
I was able to compile and test (on the ship, so it was not practical to get a very small signal, so I tested with 0.05 m, it worked).
when I had it set at 0.008 m, I think ship vibration, even docked produced 0.02 m Hsig).

Anyway, I think we are all good, Thank you so much.

Closed 2023-10-31.

Thread 107 (2025-04-10):

Request for PCB Design Files (Gerbers or Source) for OpenMetBuoy

matinkarimi234, 2025-04-10:
Hi OpenMetBuoy team,

Thanks so much for making this incredible project open-source — it's an inspiring and valuable contribution to the oceanographic and environmental monitoring communities.

I’m currently working on a similar buoy project and would love to explore or build upon your hardware design. Would it be possible for you to share the PCB design files (e.g., KiCad or Eagle source files, or even just Gerber files) for the main board(s) used in the OpenMetBuoy?

Having access to the PCB layout would be immensely helpful for prototyping and adapting the system to different use cases (e.g., GSM-based telemetry or alternative sensor setups).

Thanks again for all your work, and looking forward to any updates!

Best regards

matinkarimi234, 2025-04-10:
> Hi! Thank you for your kind words! Yes, sharing the PCB we use is fine - can you share your email address so I take contact with you there directly? :)

Yes, here is my email address:
matinkarimi234@gmail.com
