jerabaul29/OpenMetBuoy-v2021a/instrument_hardware/CircuitDiamgram_OMB.pdf

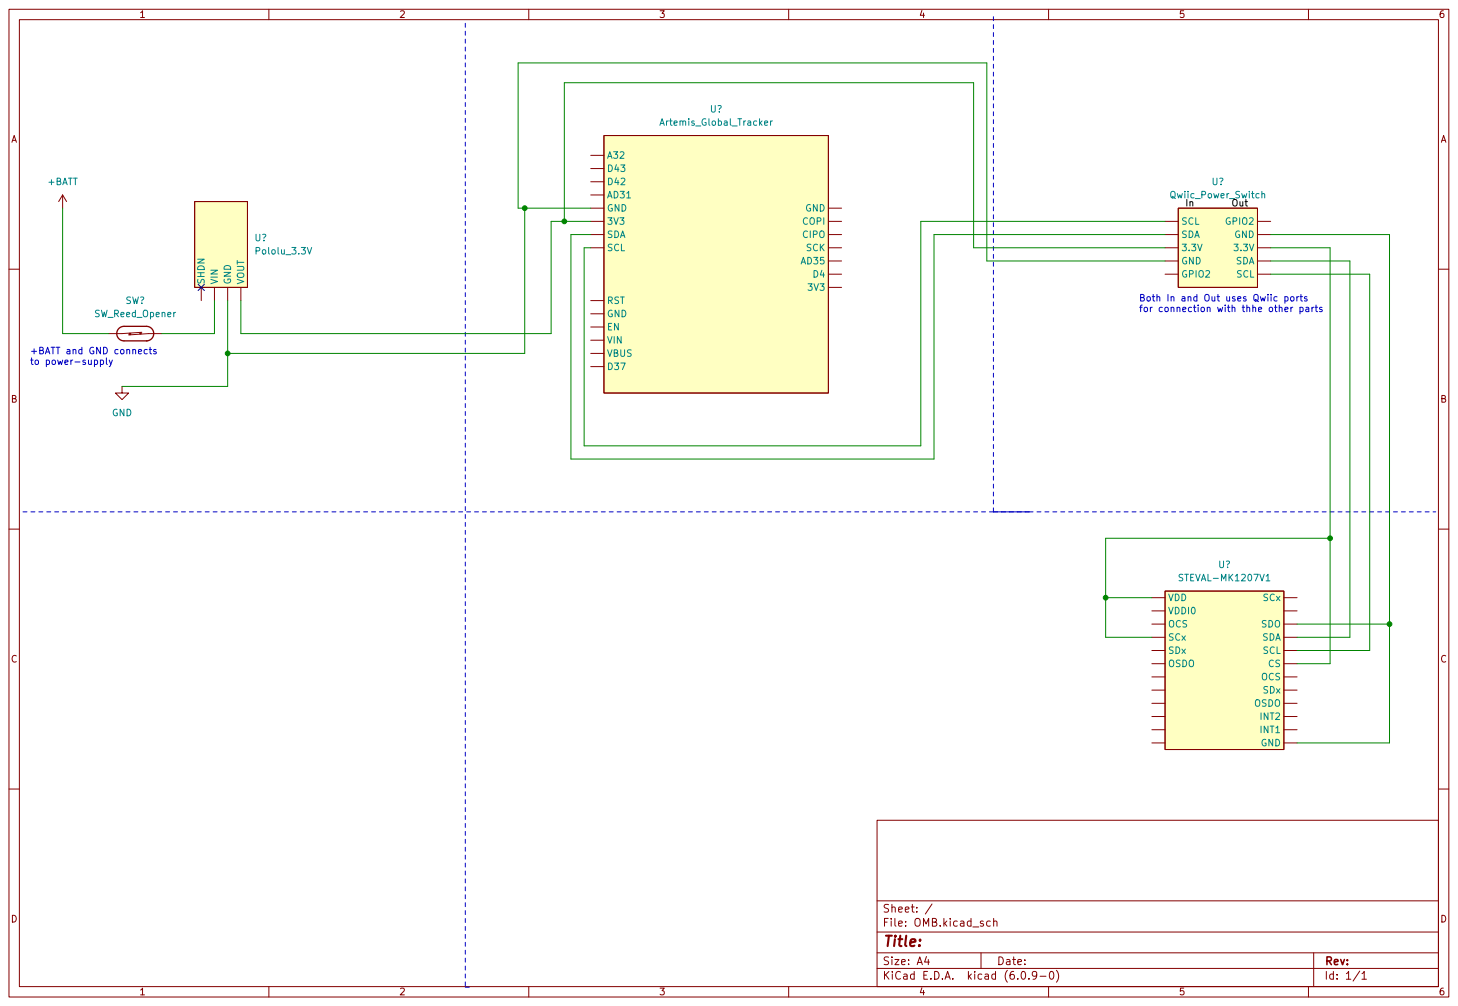
[picture p70: page 1]

Both In and Out uses Qwiic ports
for connection with thhe other parts
