jerabaul29/OpenMetBuoy-v2021a/(commit log)

2021-12-04 Add info Arduino IDE, some notes
2022-02-25 Add v1 of assembly instructions
2022-02-25 Add master schematic and some tips and tricks
2022-02-27 Add standard GPS drifter
    [board_control.cpp, board_control.h, params.cpp, params.h, tracker.ino]
2022-03-29 add note about using low AWG for power supply part
2022-03-30 note about abrupt temperature changes
2022-03-31 do not cut informative leds
2022-04-07 Update to make sure use qwiic switch
2022-04-22 Add freeze in mount explanations
2022-04-22 note about voltage drop and AWG
2022-09-08 Add the current TN PCB trace and 2 ways version
2022-10-11 Make it clear(er) that LED *should* be cut!
2022-11-07 add alternative magnetic switch
2023-01-11 prefere RND 455 if using the PCB
2023-01-12 Add processed filtering to autotest
2023-02-16 Add KiCAD schematic
2023-02-28 prefer not using the sma cable
2023-02-28 Add headers to the extras when using PCB
2023-03-14 Fix corner case for bad signal quality
2023-04-21 Add note antenna positioning
2023-07-04 Add notice prefer to use the prepring in particular for power calculations
2023-07-05 Add folder for compiling with Arduino IDE
2023-07-05 WIP on the update thermistors tracker in the tracker crrt firmware dict
2023-07-06 Just add a copy of the thermistors enabled drifter to allow diffing
    [board_control.cpp, board_control.h, params.cpp, params.h, tracker.ino]
2023-07-06 Update the thermistors: do not check attitude; reduce to4 thermistors max
2023-07-06 Update decoder for shortened thermistors; firmware/tracker now contains exactly what was used for testing
    [params.cpp, params.h, tracker.ino]
2023-08-08 WIP testbench thermistors IDs
2023-08-08 Add resistors needed for thermistors
2023-08-08 Explain how to orient magnet for Reed triggering
2023-08-10 Update thermistor testbench code
2023-08-10 Add illustration howto thermistor testbench
2024-02-05 Add bin of the thermistor ID test bench
2024-08-14 Prepare new version with 10 sensors
2024-08-14 Adapt to 10 temp sensors
2024-08-14 Add binary for 10-thermistor version
2024-09-09 Use digital pin for IMU powering on off
2024-09-11 Prepare firmware without qwiic switch
2024-09-11 Use digital pin for IMU powering + change to I2C port 1
2024-09-11 Disable thermistors altogether
2024-09-16 Put IMU on before using GNSS when sharing I2C port between IMU and GNSS
2024-09-16 Clean up non working pcb noqwiic binary
2024-09-18 Add floating broken out I2C pins
2025-02-05 Hacky OMB with IR sensor; TODO: check and clean this commit
2025-02-07 Minor cleanups, turn off the twi soft wire
2025-04-23 Prepare for IWOOS 16 sensors firmware
2025-04-23 WIP IWOOS 16 thermistors
2025-04-23 Add a bit of delay to avoid overloading DS18B20 power
2025-04-24 Add decoder for 16 thermistors string
2025-04-24 Add bin IWOOS 16 thermistors
2025-05-02 Copy firmware to start work on short high resolution string
    [board_control.cpp, board_control.h, params.cpp, params.h, tracker.ino]
2025-05-02 Add missing nbr packets
    [tracker.ino]
2025-05-07 change sample rates iwoos
2026-04-13 Update list of components with enclosure and battery advice
    Added a suggestion for a larger enclosure and provided advice on battery types and holders.
2026-06-03 Make IWOOS version with 1 week forced reboot
    [params.h, tracker.ino]
2026-06-03 Start work 27 regular reboot
    [board_control.cpp, board_control.h, params.cpp, params.h, tracker.ino]
2026-06-04 Fix wrong obj name
    [tracker.ino]
2026-06-04 Start work version 45 sensors
2026-06-12 Add 45 thermistors decoder
