jerabaul29/OpenMetBuoy-v2021a/end_user_manual/assets/labmaker_omb.jpg

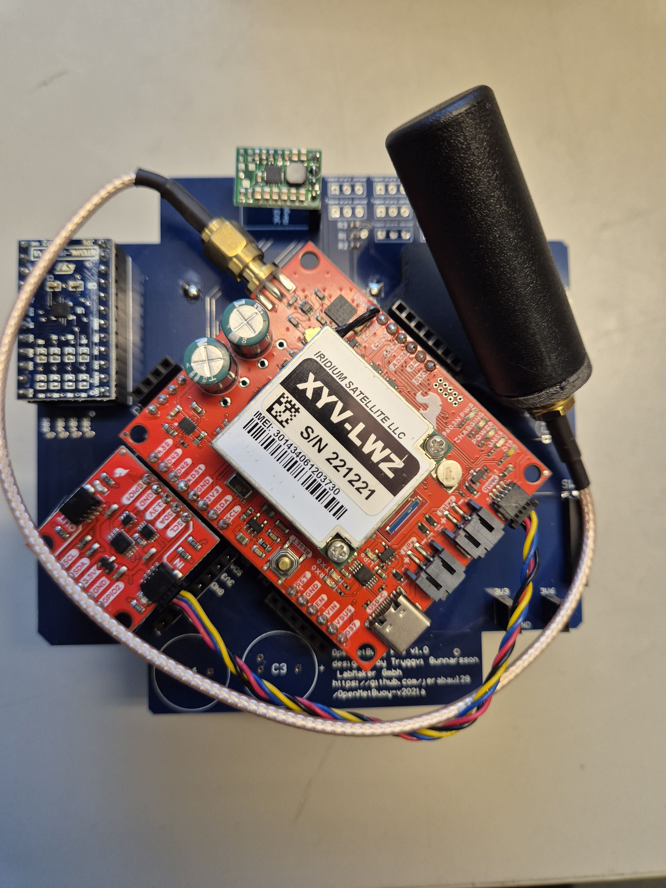
[picture p69: end_user_manual/assets/labmaker_omb.jpg]
end_user_manual/assets/labmaker_omb.jpg
